TinkerBarn/U1-Argus-Remote-RFID/THIRD_PARTY_NOTICES.md

# Third-Party Notices

This repository includes ideas, implementation patterns, and in parts adapted logic from external projects.

## Included or Referenced Upstream Projects

### wasikuss / snapmaker-u1-remote-rfid-reader

- Repository: https://github.com/wasikuss/snapmaker-u1-remote-rfid-reader
- License: MIT
- Source confirmation: the repository README identifies the project as `MIT license`

Relevant note:

- MIT-licensed material remains subject to the original copyright and permission notice requirements.

### baze / snapmaker-u1-drybox-nfc-reader

- Repository: https://gitlab.com/baze/snapmaker-u1-drybox-nfc-reader
- License label shown by GitLab: Creative Commons Attribution Non Commercial 4.0 International

Relevant note:

- Because this project borrows from a source labeled `CC BY-NC 4.0`, this repository is published under a non-commercial license to stay aligned with that upstream restriction.

## Additional Acknowledgements

Special thanks and respect to:

- https://github.com/paxx12
- https://github.com/wasikuss
- https://gitlab.com/baze

## Why This Repository Uses CC BY-NC 4.0

The `wasikuss` repository is MIT, which is permissive.

The `baze` repository is labeled `Creative Commons Attribution Non Commercial 4.0 International`, which is more restrictive and prohibits commercial use.

Because material from both lines influenced this repository, the overall public repository is distributed under `CC BY-NC 4.0` so that the resulting publication does not become more permissive than the most restrictive upstream source used here.
