TinkerBarn/U1-Argus-Remote-RFID/docs/USER_GUIDE_ESP32-S3.md

# User Guide: ESP32-S3 Dual-Reader

This guide describes the ESP32-S3 N16R8 `V1.8` version of the U1 Argus Remote
RFID reader. One controller operates two PN532 readers for the left and right
spool positions and sends detected data to their assigned Snapmaker U1 Tool
Heads.

## Requirements

- ESP32-S3 N16R8 with two PN532 modules in HSU/UART mode
- Installed ESP32-S3 firmware `V1.8`
- Snapmaker U1 with Extended Firmware
- **Filament Detection** set to **External** in the printer firmware settings
- A **2.4 GHz** Wi-Fi network

The ESP32-S3 supports `802.11 b/g/n` Wi-Fi in the 2.4 GHz band. It cannot
connect to a 5 GHz-only network, even when other nearby devices preferentially
use 5 GHz.

## Printable SH02 Installation

The MakerWorld model below provides a base plate optimized for one or two
**Sovol / Comgrow SH02** filament dryers, with a front ESP32-S3 mounting
position and two matching PN532 sensor holders:

- [Dual RFID Reader for SH02 Dryer and Snapmaker U1](https://makerworld.com/en/models/2847054-dual-rfid-reader-for-sh02-dryer-and-snapmaker-u1#profileId-3175165)

The same model also provides optional ESP32-C3 holder parts and universal
ESP32-C3 holder variants for alternative installations.

## What The S3 Version Does Differently

The S3 release combines two local readers in one controller:

- **Left spool** and **Right spool** each have their own PN532 module and
  Tool Head assignment.
- A FreeRTOS task on Core 0 services the NFC readers.
- The Arduino main loop on Core 1 services the web interface, Wi-Fi, and
  printer communication.
- The validated fast PN532 HSU read path supports OpenSpool/NTAG and
  QIDI/MIFARE Classic tags.

This separation keeps blocking NFC polling away from web and network
processing. `V1.8` retains the permanent dual-slot layout for signed OTA
firmware updates, safer card identity handling, and printer self-heal behavior.
It keeps both unloaded readers on the fast polling interval after feeder
activity and sends fully read tag metadata immediately. It also provides an
optional UID-only mode for paxx12/Spoolman installations.

## First Setup

On first boot, or after stored settings have been cleared, the device opens:

- SSID: `U1-Argus-Setup-XXXX`
- Configuration page: `http://192.168.4.1`

Connect a phone or computer to the hotspot. If the captive portal does not
open automatically, open the configuration address manually.

## Setup Web Interface

| Setting | Purpose |
| --- | --- |
| Wi-Fi SSID / Password | Access to the 2.4 GHz Wi-Fi network with the Snapmaker U1 |
| Preferred BSSID 1 / 2 | Optional priority for particular 2.4 GHz access points broadcasting the same SSID |
| Hostname | Local reader name, for example `argus-dual`; accessible as `http://argus-dual.local` |
| Printer IP / Hostname | IP address or mDNS hostname of the Snapmaker U1 |
| Printer Port | API port; default is `7125` |
| Left spool Tool Head | Printer channel for the local left PN532 |
| Right spool Tool Head | Printer channel for the local right PN532 |
| Additional dual reader | Optional link to another two-spool reader with its left/right Tool Heads |
| OpenSpool UID-only Mode | Sends only the UID of every readable tag so paxx12 can resolve filament data through Spoolman; disabled by default |
| Debug serial log | Additional serial output and a live dashboard log panel; it can slow tag detection and is disabled by default |
| QIDI config upload / reset | Updates or removes custom QIDI material and manufacturer mappings |
| Signed Firmware Update | Automatically checks the published S3 update catalog and installs a selected signed OTA file with visible progress |

With debug disabled, essential serial information remains available, including
the setup hotspot, Wi-Fi status, a tag detection line, and printer transfer
status. `V1.8` also reports visible 2.4 GHz BSSIDs for the configured
SSID with their RSSI values when the list is initially scanned or changes.

When opened from the first-boot captive portal, Setup intentionally shows only
the fields required for initial Wi-Fi, reader, printer, and local tool-head
configuration. Advanced sections such as QIDI config upload, signed firmware
update, diagnostics, and additional-reader configuration are available after
the device has joined Wi-Fi and Setup is opened from the normal dashboard.

Setup provides Save-and-reboot controls at the beginning and end of the form,
plus a fixed bottom save bar. Enable **Debug serial log**, save, and allow the
reader to restart before looking for the live log on the dashboard.

## DebugSerial Live Log

When **Debug serial log** is enabled, the dashboard shows a live copy of the
firmware's serial output. The panel can be expanded, paused, cleared, kept
scrolled to the newest line, or downloaded as a text file. It uses a bounded
RAM buffer; older lines are replaced when the device buffer fills, and the
page marks that gap. Logs are not written to flash.

The `FLOW` lines distinguish the important stages of a moving-tag read:

- `UID detected` means the PN532 saw a tag, but its content may not yet be complete.
- `OpenSpool content read=OK/FAILED` reports whether the payload was read.
- `queue=accepted` and `dequeue ... wait=` show handoff to printer processing.
- `SET BLOCKED` explains that the filament sensor state prevented an update.
- `SET START` and `SET END` show the actual printer request and HTTP result.

Keep the live log disabled for normal printing because verbose serial output
can reduce RFID timing margin.

## Printer Send Compatibility

`V1.8` sends `CARD_UID` with parsed QIDI and OpenSpool tag data so newer
printer-side integrations can identify the physical card. It also sends
`CARD_TYPE` where supported:

| Tag family | `CARD_TYPE` |
| --- | --- |
| QIDI / MIFARE Classic | `M1` |
| OpenSpool / NTAG / MIFARE Ultralight | `NTAG` |

If the printer firmware rejects `CARD_TYPE`, the reader automatically retries
the same update without `CARD_TYPE` and keeps using `CARD_UID`.

After a complete tag read, V1.8 sends the full mapped metadata immediately.
It does not send UID-only data after a temporary tag read or parse failure.
This avoids clearing existing printer filament data when a tag was only
partially read while moving past the PN532.

In normal mode, a correctly read NTAG with a valid but empty NDEF record
(`Len=0`) is treated as an intentional UID-only lookup tag. A failed memory
read, missing NDEF structure, malformed record, or unsupported non-empty
content does not activate this fallback.

If the printer later reports a previously updated channel as cleared
(`NONE`, no card UID, and zero temperatures), the reader can re-send the last
successfully sent tag payload for that spool as a self-heal repair. This repair
is allowed both before and after the Tool Head filament sensor reports
`filament_detected=true`. Normal new-tag changes are still only allowed while
`filament_detected=false`.

## OpenSpool UID-only Mode

V1.8 adds **OpenSpool UID-only Mode** to Setup. It is disabled by default.
When enabled, the reader stops after detecting a tag UID and sends a standard
printer update containing the assigned channel and `CARD_UID` only. It does
not authenticate QIDI data or read NDEF/OpenSpool filament information from
the tag.

Requirements:

- Snapmaker U1 running paxx12 firmware with the Spoolman option enabled
- A reachable Spoolman server
- A filament/spool record in Spoolman whose UID exactly matches the detected tag

This mode reduces the amount of RFID reading and data transfer, uses the
filament information maintained in Spoolman, and can support otherwise unknown
tags as long as the PN532 can detect their UID. Its limitation is intentional:
without a matching Spoolman profile for that UID, no filament metadata can be
resolved. Disable the setting to restore normal QIDI/OpenSpool content reading
and the empty-NDEF NTAG fallback.

## Preferred BSSIDs

A **BSSID** is the MAC address of a specific Wi-Fi radio, for example
`AA:BB:CC:DD:EE:FF`. This is useful when several access points or mesh nodes
broadcast the same SSID and the reader should prefer a nearby or stable
2.4 GHz access point.

When BSSIDs are configured, the firmware connects in this order:

1. It scans visible networks for the configured SSID and BSSID 1.
2. If BSSID 1 is not visible, it tries BSSID 2.
3. Only when neither preferred access point is visible does it use another
   visible access point with the same SSID.

Enter only the BSSID of a **2.4 GHz** network. The ESP32-S3 cannot use the
BSSID of a 5 GHz radio.

### List Available BSSIDs On Windows

Open PowerShell or Command Prompt:

```powershell
netsh wlan show networks mode=bssid
```

For a shorter PowerShell view:

```powershell
netsh wlan show networks mode=bssid | Select-String 'SSID|BSSID|Signal|Channel'
```

Find your SSID and select the BSSID of a 2.4 GHz channel. In most regions,
2.4 GHz Wi-Fi channels are numbered from `1` through `13`.

### List Available BSSIDs On macOS

On macOS versions that still include the older `airport` system utility, run
a scan in Terminal:

```sh
/System/Library/PrivateFrameworks/Apple80211.framework/Versions/Current/Resources/airport -s
```

Apple does not include this private utility on every newer macOS version. If
the command is unavailable, open **Wireless Diagnostics** and select
**Window > Scan**, or hold `Option` while clicking the Wi-Fi icon to view the
BSSID of the currently connected access point.

## Supported Tags

- **OpenSpool / NTAG**: Reads OpenSpool NDEF content through the respective
  reader and transfers material data to its Tool Head. A valid empty NDEF
  record can be sent as a UID-only lookup.
- **QIDI / MIFARE Classic**: Authenticates and reads the QIDI data block,
  maps material, manufacturer, and color codes, and updates the relevant
  channel.
- **UID-only mode**: Uses any ISO14443A tag that the PN532 can detect and sends
  only its UID; filament data must be resolved by the printer/Spoolman setup.

## QIDI `officiall_filas_list.cfg`

The firmware includes compact default mappings for common QIDI Plus4
materials. The optional QIDI file `officiall_filas_list.cfg` can be uploaded
in Setup. The double `l` spelling is the filename expected by the firmware.

The upload persistently updates:

- material numbers and their displayed material names,
- manufacturer numbers and their displayed manufacturer names.

It does not overwrite RFID tags or install anything on the printer. Resetting
the QIDI configuration removes uploaded mappings and activates the built-in
defaults again.

## Dashboard

The S3 dashboard displays both local spool positions separately.

| Area | Information Shown |
| --- | --- |
| Status bar | Wi-Fi connection, printer reachability, and current tag status |
| Left/Right Printer Tool Head | Assigned channel and printer-confirmed manufacturer, material, color, temperature, sensor, and official data |
| Left/Right Tag Reader | Most recently read UID, tag source (`OpenSpool` or `QIDI`), manufacturer, material, color, and temperature values for each spool |
| Set result | Result of the last update to the relevant printer channel, including HTTP status |
| Network | SSID, IP address, hostname, signal strength, currently connected BSSID, firmware version, and visible 2.4 GHz BSSIDs for the configured SSID with RSSI and channel |
| Additional Reader | Quick access to an optional additional two-spool dashboard |

## Filament-Loaded Safety Lock

Starting with `V1.2`, each local reader is protected independently after
filament reaches its assigned Tool Head:

- Immediately before sending different tag data, the firmware checks the
  filament sensor for the matching Tool Head.
- A tag update is sent only when that sensor reports **No filament**.
- When a side reports **Filament detected**, RFID polling pauses for that side
  and its printer motion status is checked approximately every five seconds.
- The other spool reader remains available for a new spool and tag.
- After filament is removed, the paused side resumes normal RFID detection and
  update behavior.

This prevents an accidental or incorrect tag read from changing the material
data of filament already loaded for printing.

## Stationary Tag Throttling

Starting with `V1.3`, a spool that stops with its tag continuously in front of
a reader no longer causes continuous duplicate processing:

- The first valid tag data is handled immediately as before.
- When the same UID and decoded content remain at the same reader for
  3 seconds, that reader pauses reads for 2 seconds.
- After each pause, the tag is checked once again. If it is still unchanged,
  another 2-second pause begins.
- If the tag content changes, or a different tag is presented, the new data is
  processed immediately on the next check.

The periodic confirmation still permits the reader to correct printer data if
a previous SET request did not succeed, while preventing a parked spool from
making the dashboard slow.

## Initial Setup

1. Start the reader and connect to its `U1-Argus-Setup-XXXX` hotspot.
2. Open the captive portal, or manually open `http://192.168.4.1`.
3. Configure Wi-Fi, printer address, left/right Tool Heads, and optional
   preferred BSSIDs or additional reader dashboard.
4. Save the configuration and let the reader reboot.

## Normal Operation

1. Start the printer and the configured reader.
2. Load a filament spool with an attached OpenSpool or QIDI tag into the
   left or right dryer/reader position.
3. The reader detects the tag automatically and transfers the filament
   information to the assigned printer Tool Head when required.

Once configured, there is normally nothing else to operate: load filament and
print.

## Changing Settings Or Viewing Details

Open the configured reader URL, for example `http://argus-dual.local`, or its
displayed IP address only when you want to view dashboard details or change
setup values. Keep debug logging disabled for normal use and enable it only
temporarily for troubleshooting.

## Signed OTA Firmware Update

`V1.3` and later provide safe web-based firmware updates for the ESP32-S3:

1. Open the reader setup page through its hostname or IP address.
2. The **Signed Firmware Update** section automatically checks the published
   S3 update catalog. Select **Check for updates** to retry manually.
3. Download the offered `*.ota.signed.bin` file when a newer S3 release is
   available.
4. Select the downloaded file in the update form and confirm installation.
5. Watch the progress bar while the file is uploaded and verified.
6. After a valid update, the reader restarts; the setup page waits for the
   device to return and reloads automatically.

The reader verifies the firmware signature before activating an uploaded
image. A damaged, unsigned, or wrong image is rejected and the currently
running firmware remains available.

Important migration note: `V1.0`, `V1.1`, and `V1.2` use an older flash
layout. Install `V1.3` once through the Web Installer or USB before using OTA
updates. From `V1.3` onward, updates use the permanent dual-slot layout.

## Manual Arduino IDE Upload Settings

For the tested ESP32-S3 dual-reader board, use:

| Setting | Value |
| --- | --- |
| Board | `ESP32S3 Dev Module` |
| CPU Frequency | `240MHz (WiFi)` |
| Flash Mode | `QIO 80MHz` |
| Flash Size | `16MB (128Mb)` |
| Partition Scheme | `Custom` using the included `partitions.csv` |
| PSRAM | `OPI PSRAM` |
| Arduino Runs On / Events Run On | `Core 1` / `Core 1` |
| USB CDC On Boot | `Enabled` |
| USB Mode / Upload Mode | `Hardware CDC and JTAG` / `UART0 / Hardware CDC` |

Open the complete `source/ESP32-S3/V1.8/` sketch folder in Arduino IDE so the
included `partitions.csv`, `build_opt.h`, `ota_public_key.h`, and
`debug_log_*.h` headers are present for compilation. The permanent partition layout provides two `6.25 MiB` OTA
application slots and approximately `3.4 MiB` LittleFS capacity for future
features.

Keep `Erase All Flash Before Sketch Upload` disabled for updates if existing
settings should remain stored. Hardware testing confirmed the full `16 MB`
flash capacity on the reference N16R8 board when using the provided custom
layout. Do not replace it with the predefined
`16M Flash (3MB APP/9.9MB FATFS)` partition layout.

## Troubleshooting

For connection problems, first verify that a configured preferred BSSID
belongs to your 2.4 GHz SSID and is visible at the installation location.
Then check the printer address, port `7125`, and
**Filament Detection: External**.

## References

- [Espressif ESP32-S3 product overview](https://www.espressif.com/en/products/socs/esp32-s3/)
- [Espressif ESP32 chip comparison with Wi-Fi band and CPU information](https://docs.espressif.com/projects/esp-idf/en/v5.0.3/esp32c3/hw-reference/chip-series-comparison.html)
- [Microsoft documentation for `netsh wlan`](https://learn.microsoft.com/en-us/windows-server/administration/windows-commands/netsh-wlan)
