TinkerBarn/U1-Argus-Remote-RFID/source/ESP32-S3/V1.8/U1_Argus_Remote_RFID_ESP32-S3_N16R8_V1_8.ino

/*
  U1 Argus Remote RFID - ESP32-S3 N16R8 V1.8

  Target: ESP32-S3 N16R8 + 2x PN532 (HSU/UART)

  Required libraries:
  - Adafruit PN532
  - ArduinoJson

  Wiring for ESP32-S3 N16R8 -> PN532 in HSU/UART mode:
  - 3V3        -> both PN532 VCC
  - GND        -> both PN532 GND
  Alternative pin test:
  - GPIO11 TX  -> left PN532 pin labeled SCL
  - GPIO12 RX  -> left PN532 pin labeled SDA
  - GPIO13 TX  -> right PN532 pin labeled SCL
  - GPIO14 RX  -> right PN532 pin labeled SDA
*/

#include <WiFi.h>
#include <stdio.h>
#include <stdarg.h>
#include <string.h>
#include <DNSServer.h>
#include <WebServer.h>
#include <ESPmDNS.h>
#include <HTTPClient.h>
#include <Preferences.h>
#include <ArduinoJson.h>
#include <Adafruit_PN532.h>
#include <HWCDC.h>
#include <soc/soc_caps.h>
#include <freertos/FreeRTOS.h>
#include <freertos/task.h>
#include <freertos/queue.h>
#include <esp_ota_ops.h>
#include <Update.h>
#include "ota_public_key.h"

#ifndef ARDUINO_USB_MODE
#define ARDUINO_USB_MODE 0
#endif
#ifndef ARDUINO_USB_CDC_ON_BOOT
#define ARDUINO_USB_CDC_ON_BOOT 0
#endif

// Mirror Serial logs to the ESP32-S3 USB-Serial/JTAG port when the Arduino
// board profile maps Serial to UART0 or native USB CDC instead.
#if SOC_USB_SERIAL_JTAG_SUPPORTED && !(ARDUINO_USB_MODE && ARDUINO_USB_CDC_ON_BOOT)
static HWCDC DebugUsbJtagSerial;
#define U1A_HAS_USB_JTAG_LOG 1
#else
#define U1A_HAS_USB_JTAG_LOG 0
#endif

#include "debug_log_buffer.h"
#include "debug_log_panel.h"
static bool gDebugSerialEnabled = false;
static DebugLogBuffer<16384> webDebugLog;
static portMUX_TYPE webDebugLogMux = portMUX_INITIALIZER_UNLOCKED;
static uint32_t webDebugBootId = 0;

class SerialMirrorLogger {
static void mirrorWebDebugLog(const char* text, size_t length) {
  if (!gDebugSerialEnabled || !text || !length) return;
  // Bounded copies only; no allocation or networking while the NFC task logs.
  portENTER_CRITICAL(&webDebugLogMux);
  webDebugLog.append(text, length);
  portEXIT_CRITICAL(&webDebugLogMux);
}
public:
  void begin(unsigned long baud) {
    ::Serial.begin(baud);
#if U1A_HAS_USB_JTAG_LOG
    DebugUsbJtagSerial.begin(baud);
#endif
  }

  size_t print(const char* s) {
    mirrorWebDebugLog(s, strlen(s));
    size_t written = ::Serial.print(s);
#if U1A_HAS_USB_JTAG_LOG
    DebugUsbJtagSerial.print(s);
#endif
    return written;
  }

  size_t print(char c) {
    mirrorWebDebugLog(&c, 1);
    size_t written = ::Serial.print(c);
#if U1A_HAS_USB_JTAG_LOG
    DebugUsbJtagSerial.print(c);
#endif
    return written;
  }

  size_t print(const String& s) {
    mirrorWebDebugLog(s.c_str(), s.length());
    size_t written = ::Serial.print(s);
#if U1A_HAS_USB_JTAG_LOG
    DebugUsbJtagSerial.print(s);
#endif
    return written;
  }

  size_t println(const char* s) {
    mirrorWebDebugLog(s, strlen(s));
    mirrorWebDebugLog("\n", 1);
    size_t written = ::Serial.println(s);
#if U1A_HAS_USB_JTAG_LOG
    DebugUsbJtagSerial.println(s);
#endif
    return written;
  }

  size_t println(const String& s) {
    mirrorWebDebugLog(s.c_str(), s.length());
    mirrorWebDebugLog("\n", 1);
    size_t written = ::Serial.println(s);
#if U1A_HAS_USB_JTAG_LOG
    DebugUsbJtagSerial.println(s);
#endif
    return written;
  }

  size_t println() {
    mirrorWebDebugLog("\n", 1);
    size_t written = ::Serial.println();
#if U1A_HAS_USB_JTAG_LOG
    DebugUsbJtagSerial.println();
#endif
    return written;
  }

  int printf(const char* fmt, ...) {
    char buf[512];
    va_list args;
    va_start(args, fmt);
    int len = vsnprintf(buf, sizeof(buf), fmt, args);
    va_end(args);
    if (len < 0) return len;
    print(buf);
    return len;
  }

  void flush() {
    ::Serial.flush();
#if U1A_HAS_USB_JTAG_LOG
    DebugUsbJtagSerial.flush();
#endif
  }
};

static SerialMirrorLogger DebugSerial;
#undef Serial
#define Serial DebugSerial

// ============================== Version ==============================
static const char* FW_NAME = "U1 Argus Remote RFID";
static const char* FW_VERSION = "V1.8";
static const char* BOARD_LABEL = "ESP32-S3 N16R8";
static const char* OTA_UPDATE_CATALOG_URL = "https://tinkerbarn.github.io/U1-Argus-Remote-RFID/updates/esp32-s3.json";
static const size_t OTA_SIGNATURE_BYTES = 512;
static const size_t OTA_APP_SLOT_BYTES = 0x640000;

// ============================== Debug ==============================
static const uint32_t SERIAL_BAUD = 115200;

// This S3 board has an addressable RGB LED on GPIO48, not a simple status LED.
static const int TAG_LED_PIN = -1;
static const bool TAG_LED_ACTIVE_HIGH = true;
static const uint32_t TAG_LED_HOLD_MS = 300;
static const uint32_t TAG_ERROR_BLINK_MS = 120;
#define NFC_DIAG_SERIAL (isDebugSerialEnabled())
static const uint32_t NFC_NO_TAG_LOG_MS = 5000;

// ============================== Pins ==============================
// Wiring for ESP32-S3 N16R8 -> PN532 in HSU/UART mode:
// - 3V3        -> both PN532 VCC
// - GND        -> both PN532 GND
// Alternative pin test:
// - GPIO11 TX  -> left PN532 pin labeled SCL
// - GPIO12 RX  -> left PN532 pin labeled SDA
// - GPIO13 TX  -> right PN532 pin labeled SCL
// - GPIO14 RX  -> right PN532 pin labeled SDA
//
// IMPORTANT:
// - The PN532 board must be switched to HSU/UART mode.
// - Some PN532 boards keep the printed SCL/SDA labels even when the mode
//   switches are set to HSU/UART. We therefore follow the known-good wiring
//   from your other project exactly.
// - Reset is optional and is not wired in the initial 4-wire setup.
static const uint8_t READER_COUNT = 2;
static const char* READER_LABELS[READER_COUNT] = {"Left spool", "Right spool"};
static const int PN532_RX_PINS[READER_COUNT] = {12, 14};
static const int PN532_TX_PINS[READER_COUNT] = {11, 13};
static const int PN532_RESET_PINS[READER_COUNT] = {-1, -1};
static const uint32_t PN532_BAUD = 115200;

// ============================== Timing ==============================
static const uint32_t WIFI_CONNECT_TIMEOUT_MS = 30000;
static const uint32_t WIFI_PORTAL_FALLBACK_MS = 30000;
static const uint32_t WIFI_RECOVERY_RETRY_MS = 15000;
static const uint32_t WIFI_RECOVERY_ATTEMPT_MS = 6000;
static const uint32_t WIFI_STARTUP_STAGGER_MAX_MS = 2500;

// --- NFC polling intervals ---
// BENCH:  used at startup / when feeder has never triggered.  Both readers alternate.
// IDLE:   feeder known but currently inactive.  Both unlocked readers alternate at the startup interval.
// ACTIVE: one reader has focus-lock or feeder is pulling filament.  Single reader, fast.
static const uint32_t TAG_BENCH_POLL_MS = 30;     // V0.7: was 45 – faster dual-scan startup
static const uint32_t TAG_IDLE_POLL_MS = 30;     // keep unlocked readers fast after feeder events
static const uint32_t TAG_ACTIVE_POLL_MS = 12;
static const uint32_t TAG_ACTIVE_WINDOW_MS = 1200;

// Short focus while a detected tag is being handled. V0.18 releases this focus
// immediately after each completed read attempt so re-reading is not blocked.
static const uint32_t TAG_DETECT_FOCUS_MS = 600;

static const uint32_t TAG_SAME_UID_SKIP_MS = 0;
static const uint32_t TAG_UNCHANGED_ACTIVE_MS = 3000;
static const uint32_t TAG_UNCHANGED_PAUSE_MS = 2000;
static const uint32_t FEEDER_PRIORITY_WINDOW_MS = 4000; // release exclusive feeder focus sooner after one load
static const uint32_t PRINTER_MOTION_QUERY_MS = 600;
static const uint32_t PRINTER_LOADED_MOTION_QUERY_MS = 5000;
static const uint32_t PRINTER_INFO_SYNC_MS = 90000;
static const uint32_t PRINTER_WS_RECONNECT_MS = 5000;
static const uint32_t PRINTER_WS_STALE_MS = 20000;
static const uint32_t PRINTER_WS_PING_MS = 15000;
static const size_t PRINTER_WS_FRAME_BUFFER_BYTES = 8192;
static const uint32_t PRINTER_TAG_INFO_MAX_AGE_MS = 1000;
static const uint32_t PRINTER_QUERY_JITTER_MS = 450;
static const uint8_t PRINTER_QUERY_STAGGER_SLOTS = 4;
static const uint16_t PRINTER_QUERY_TIMEOUT_MS = 700;
static const uint32_t WEBHOOK_VERIFY_DELAY_MS = 1200;
static const uint32_t WEBHOOK_VERIFY_RETRY_MS = 1800;
static const uint8_t WEBHOOK_VERIFY_MAX_RETRIES = 0;
static const uint32_t WEBHOOK_RESEND_GRACE_MS = 6000;
static const uint32_t PRINTER_LOST_INFO_REPAIR_COOLDOWN_MS = 15000;
static const uint16_t PN532_CMD_TIMEOUT_MS = 100;
static const uint16_t PN532_ACK_TIMEOUT_MS = 10;
// Detect timeouts: how long InListPassiveTarget blocks waiting for a tag.
// SCAN  (dual-reader, no focus) – keep short so we rotate between readers quickly.
// ACTIVE (single focused reader) – can be longer; we know a tag is likely there.
static const uint16_t PN532_TAG_DETECT_TIMEOUT_BENCH_MS = 60;
static const uint16_t PN532_TAG_DETECT_TIMEOUT_IDLE_MS  = 60;
static const uint16_t PN532_TAG_DETECT_TIMEOUT_ACTIVE_MS = 60;
static const uint16_t PN532_MIFARE_TIMEOUT_MS = 80;
static const uint16_t PN532_FAST_READ_TIMEOUT_MS = 120;
static const bool PN532_USE_LIBRARY_TAG_DETECT = false;
static const bool PN532_SWITCH_RF_FIELD_BETWEEN_READERS = false;
static const uint8_t PN532_RF_SETTLE_MS = 8;
static const uint8_t PN532_POST_READ_RF_RESET_MS = 4;
static const uint8_t PN532_PASSIVE_RETRIES = 0x10;
static const uint8_t PN532_BOOT_RECOVERY_ATTEMPTS = 2;
static const uint8_t TAG_READ_SETTLE_MS = 2;
static const uint8_t NTAG_FIRST_USER_PAGE = 4;
static const uint8_t NTAG_LAST_USER_PAGE = 225;
static const size_t NTAG_USER_BYTES = (NTAG_LAST_USER_PAGE - NTAG_FIRST_USER_PAGE + 1) * 4;
static const uint8_t NTAG_CC_PAGE = 3;
static const uint8_t NTAG_INITIAL_FAST_READ_PAGES = 16;
static const uint8_t NTAG_FAST_READ_PAGES = 48;

// ============================== QIDI UID cache ==============================
// Disabled by default: reprogrammed QIDI tags can keep the same UID while material,
// vendor, and color bytes change.
static const uint8_t QIDI_UID_CACHE_SIZE = 4; // enough for 2 readers with one spare each
static const bool QIDI_UID_CACHE_ENABLED = false;
static const uint32_t QIDI_PRESENT_CACHE_MS = 1500;
static const uint32_t QIDI_AUTH_FAIL_COOLDOWN_MS = 250;
static const uint8_t QIDI_AUTH_SETTLE_MS = 0;
static const uint8_t NFC_QUEUE_DEPTH = 4;
static const size_t NFC_QUEUE_JSON_CAP = 2048;
static const uint32_t NFC_TASK_STACK_BYTES = 12288;

// ============================== Network defaults ==============================
static const char* AP_SSID_BASE = "U1-Argus-Setup";
static const char* AP_PASS = ""; // open AP as requested
static const uint16_t WEB_PORT = 80;
static const byte DNS_PORT = 53;
static const uint16_t DEFAULT_PRINTER_PORT = 7125;
static const uint8_t REMOTE_READER_COUNT = 1;
static const uint8_t WIFI_BSSID_COUNT = 2;
static const uint8_t WIFI_VISIBLE_BSSID_MAX = 32;
static const uint32_t WIFI_VISIBLE_BSSID_REFRESH_MS = 300000;
static const uint8_t PREF_CONFIG_VERSION = 2;
static const uint32_t PRINTER_MDNS_CACHE_MS = 120000;
static const uint32_t PRINTER_MDNS_RETRY_MS = 15000;
static const uint32_t PRINTER_MDNS_QUERY_TIMEOUT_MS = 800;
static const uint8_t QIDI_DATA_BLOCK = 4;
static const uint8_t QIDI_MAX_MATERIALS = 50;
static const uint8_t QIDI_MAX_VENDORS = 16;
static const size_t QIDI_CFG_UPLOAD_MAX_BYTES = 32000;

// ============================== Storage ==============================
Preferences prefs;
static const char* PREF_NS = "u1argus";
static const char* PREF_QIDI_NS = "u1qidi";

struct QidiMaterialRecord {
  uint8_t id;
  char type[18];
  uint16_t minTemp;
  uint16_t maxTemp;
} __attribute__((packed));

struct QidiVendorRecord {
  uint8_t id;
  char name[18];
} __attribute__((packed));

static const QidiMaterialRecord DEFAULT_QIDI_MATERIALS[] = {
  {1, "PLA", 190, 240},
  {2, "PLA", 190, 240},
  {3, "PLA", 190, 240},
  {4, "PLA", 190, 240},
  {5, "PLA-CF", 210, 250},
  {6, "PLA", 190, 240},
  {7, "PLA", 190, 240},
  {8, "PLA", 190, 230},
  {11, "ABS", 240, 280},
  {12, "ABS-GF", 240, 280},
  {13, "ABS", 240, 280},
  {14, "ABS", 240, 280},
  {18, "ASA", 240, 280},
  {19, "ASA-Aero", 240, 280},
  {24, "UltraPA", 260, 300},
  {25, "PA12-CF", 260, 300},
  {26, "UltraPA-CF25", 300, 320},
  {30, "PAHT-CF", 300, 320},
  {31, "PAHT-GF", 300, 320},
  {32, "PAHT-S", 260, 280},
  {33, "PA-S", 260, 280},
  {34, "PC-ABS-FR", 260, 280},
  {37, "PET-CF", 280, 320},
  {38, "PET-GF", 280, 320},
  {39, "PETG", 240, 280},
  {40, "PETG", 240, 275},
  {41, "PETG", 220, 270},
  {44, "PPS-CF", 300, 350},
  {45, "PETG", 240, 280},
  {47, "PVA", 210, 250},
  {49, "TPU-AERO", 200, 250},
  {50, "TPU", 200, 250}
};

static const QidiVendorRecord DEFAULT_QIDI_VENDORS[] = {
  {0, "Generic"},
  {1, "QIDI"}
};

static const uint32_t QIDI_COLOR_RGB[] = {
  0x000000, 0xFAFAFA, 0x060606, 0xD9E3ED, 0x5CF30F, 0x63E492,
  0x2850FF, 0xFE98FE, 0xDFD628, 0x228332, 0x99DEFF, 0x1714B0,
  0xCEC0FE, 0xCADE4B, 0x1353AB, 0x5EA9FD, 0xA878FF, 0xFE717A,
  0xFF362D, 0xE2DFCD, 0x898F9B, 0x6E3812, 0xCAC59F, 0xF28636,
  0xB87F2B
};

QidiMaterialRecord gQidiMaterials[QIDI_MAX_MATERIALS];
QidiVendorRecord gQidiVendors[QIDI_MAX_VENDORS];
uint8_t gQidiMaterialCount = 0;
uint8_t gQidiVendorCount = 0;
bool gQidiCustomConfig = false;
bool gQidiLastSaveOk = true;
uint16_t gQidiCfgBytes = 0;

struct Settings {
  char wifiSsid[33];
  char wifiPass[65];
  char wifiBssids[WIFI_BSSID_COUNT][18];
  char hostname[33];
  char printerIp[64];
  uint16_t printerPort;
  uint8_t channels[READER_COUNT];
  char remoteReaders[REMOTE_READER_COUNT][96];
  uint8_t remoteReaderTools[REMOTE_READER_COUNT][READER_COUNT];
  bool debugSerial;
  bool openSpoolUidOnly;
};

Settings gSettings = {
  "", "", {"", ""}, "u1-argus-rfid", "192.168.1.10", DEFAULT_PRINTER_PORT, {0, 1}, {""}, {{0, 0}}, false, false
};

// ============================== Web ==============================
WebServer web(WEB_PORT);
DNSServer dnsServer;
bool portalMode = false;
bool portalRoutesReady = false;
bool mdnsRunning = false;
char apSsid[32] = "";
String cachedPrinterAddress = "";
String cachedPrinterHost = "";
uint32_t cachedPrinterResolveMs = 0;
bool cachedPrinterResolveOk = false;
String qidiCfgUploadBuffer = "";
bool qidiCfgUploadTooLarge = false;
bool otaUploadActive = false;
bool otaUploadSuccessful = false;
String otaUploadStatus;
size_t otaUploadExpectedBytes = 0;
size_t otaUploadReceivedBytes = 0;

struct VisibleWifiBssidState {
  String bssid;
  int32_t rssi;
  int32_t channel;
  bool connected;
};

VisibleWifiBssidState gVisibleWifiBssids[WIFI_VISIBLE_BSSID_MAX];
uint8_t gVisibleWifiBssidCount = 0;
uint32_t lastVisibleWifiBssidScanMs = 0;
String visibleWifiBssidStateFingerprint;
bool visibleWifiScanSerialPending = false;

// ============================== PN532 ==============================
HardwareSerial PN532SerialLeft(1);
HardwareSerial PN532SerialRight(2);
HardwareSerial* PN532Serials[READER_COUNT] = {&PN532SerialLeft, &PN532SerialRight};
Adafruit_PN532 nfcLeft(PN532_RESET_PINS[0], &PN532SerialLeft);
Adafruit_PN532 nfcRight(PN532_RESET_PINS[1], &PN532SerialRight);
Adafruit_PN532* nfcs[READER_COUNT] = {&nfcLeft, &nfcRight};
bool nfcReady[READER_COUNT] = {false, false};
uint8_t activeReaderIndex = 0;
uint8_t activeNfcReaderIndex = 0;
#define PN532Serial (*PN532Serials[activeNfcReaderIndex])
#define nfc (*nfcs[activeNfcReaderIndex])

// ============================== Runtime state ==============================
struct TagState {
  bool hasData = false;
  bool active = false;
  uint32_t lastSeenMs = 0;
  String fingerprint;
  String uidHex;
  String vendor;
  String mainType;
  String subType;
  String colorHex;
  String source;
  int minTemp = -1;
  int maxTemp = -1;
  int bedTemp = -1;
  String openspoolJson;
  String mappedPayload;
};

struct OpenSpoolFields {
  String vendor;
  String mainType;
  String subType;
  String colorHex;
  int minTemp = -1;
  int maxTemp = -1;
  int bedTemp = -1;
  int alpha = -1;
  bool officialKnown = false;
  bool official = false;
};

struct PrinterChannelState {
  bool wifiConnected = false;
  bool queryOk = false;
  bool hasInfo = false;
  bool motionKnown = false;
  bool filamentDetected = false;
  bool officialKnown = false;
  bool official = false;
  int httpCode = 0;
  uint32_t lastQueryMs = 0;
  String endpoint;
  String error;
  String fingerprint;
  String vendor;
  String manufacturer;
  String mainType;
  String subType;
  String colorHex;
  String cardUidCsv;
  int minTemp = -1;
  int maxTemp = -1;
  int bedTemp = -1;
  String rawJson;
};

struct WebhookState {
  bool known = false;
  bool ok = false;
  int httpCode = 0;
  uint32_t lastSentMs = 0;
  String response;
};

struct NfcQueueItem {
  uint32_t queuedMs = 0;
  uint8_t reader = 0;
  uint8_t uid[10] = {0};
  uint8_t uidLen = 0;
  char source[20] = {0};
  char json[NFC_QUEUE_JSON_CAP] = {0};
};

struct StableTagThrottleState {
  bool valid = false;
  uint8_t uid[10] = {0};
  uint8_t uidLen = 0;
  String source;
  String content;
  uint32_t sameContentSinceMs = 0;
  uint32_t pauseUntilMs = 0;
};

QueueHandle_t nfcTagQueue = nullptr;
TaskHandle_t nfcTaskHandle = nullptr;
uint32_t lastPollMs[READER_COUNT] = {0, 0};
uint8_t lastAcceptedUid[READER_COUNT][10] = {{0}};
uint8_t lastAcceptedUidLen[READER_COUNT] = {0, 0};
uint32_t lastAcceptedUidMs[READER_COUNT] = {0, 0};
uint8_t lastQidiAuthFailUid[READER_COUNT][4] = {{0}};
bool lastQidiAuthFailKnown[READER_COUNT] = {false, false};
uint32_t lastQidiAuthFailMs[READER_COUNT] = {0, 0};
StableTagThrottleState stableTagThrottle[READER_COUNT];

// ============================== QIDI UID → JSON cache ==============================
// Kept as an optional implementation detail, but disabled for normal builds because
// rewritten QIDI cards can retain the same UID.
struct QidiUidCacheEntry {
  uint8_t  uid[4];
  bool     valid;
  char     json[256]; // max expected QIDI JSON is well under 200 chars
};
static QidiUidCacheEntry qidiUidCache[QIDI_UID_CACHE_SIZE] = {};

struct QidiPresenceCacheEntry {
  uint8_t uid[4];
  bool valid;
  uint32_t lastSeenMs;
  char json[256];
};
static QidiPresenceCacheEntry qidiPresenceCache[READER_COUNT] = {};

static bool qidiCacheLookup(const uint8_t* uid, String& outJson) {
  if (!QIDI_UID_CACHE_ENABLED) return false;
  for (uint8_t i = 0; i < QIDI_UID_CACHE_SIZE; i++) {
    if (!qidiUidCache[i].valid) continue;
    if (memcmp(qidiUidCache[i].uid, uid, 4) == 0) {
      outJson = String(qidiUidCache[i].json);
      return true;
    }
  }
  return false;
}

static void qidiCacheStore(const uint8_t* uid, const String& json) {
  if (!QIDI_UID_CACHE_ENABLED) return;
  // Find an empty slot; if none, evict the first (oldest) entry (simple FIFO).
  int8_t slot = -1;
  for (uint8_t i = 0; i < QIDI_UID_CACHE_SIZE; i++) {
    if (!qidiUidCache[i].valid) { slot = (int8_t)i; break; }
  }
  if (slot < 0) {
    // No free slot: rotate – shift entries down, free slot 0
    for (uint8_t i = 0; i < QIDI_UID_CACHE_SIZE - 1; i++) qidiUidCache[i] = qidiUidCache[i + 1];
    slot = QIDI_UID_CACHE_SIZE - 1;
    qidiUidCache[slot].valid = false;
  }
  memcpy(qidiUidCache[slot].uid, uid, 4);
  size_t n = json.length();
  if (n >= sizeof(qidiUidCache[slot].json)) n = sizeof(qidiUidCache[slot].json) - 1;
  memcpy(qidiUidCache[slot].json, json.c_str(), n);
  qidiUidCache[slot].json[n] = '\0';
  qidiUidCache[slot].valid = true;
}

static bool qidiPresenceCacheLookup(uint8_t reader, const uint8_t* uid, String& outJson) {
  if (reader >= READER_COUNT || !uid) return false;
  QidiPresenceCacheEntry& entry = qidiPresenceCache[reader];
  if (!entry.valid) return false;
  if (memcmp(entry.uid, uid, 4) != 0) return false;
  uint32_t now = millis();
  if ((now - entry.lastSeenMs) > QIDI_PRESENT_CACHE_MS) {
    entry.valid = false;
    return false;
  }
  entry.lastSeenMs = now;
  outJson = String(entry.json);
  return true;
}

static void qidiPresenceCacheStore(uint8_t reader, const uint8_t* uid, const String& json) {
  if (reader >= READER_COUNT || !uid) return;
  QidiPresenceCacheEntry& entry = qidiPresenceCache[reader];
  memcpy(entry.uid, uid, 4);
  size_t n = json.length();
  if (n >= sizeof(entry.json)) n = sizeof(entry.json) - 1;
  memcpy(entry.json, json.c_str(), n);
  entry.json[n] = '\0';
  entry.lastSeenMs = millis();
  entry.valid = true;
}

static void qidiPresenceCacheNoteNoTag(uint8_t reader) {
  if (reader >= READER_COUNT) return;
  QidiPresenceCacheEntry& entry = qidiPresenceCache[reader];
  if (!entry.valid) return;
  if ((millis() - entry.lastSeenMs) > QIDI_PRESENT_CACHE_MS) {
    entry.valid = false;
  }
}
uint32_t lastNfcProbeLogMs[READER_COUNT] = {0, 0};
uint32_t lastTagSeenMs[READER_COUNT] = {0, 0};
uint32_t tagLedUntilMs = 0;
uint32_t nextMotionQueryMs[READER_COUNT] = {0, 0};
uint32_t nextInfoSyncMs[READER_COUNT] = {0, 0};
uint32_t lastPrinterInfoQueryMs[READER_COUNT] = {0, 0};
uint32_t lastFeederMotionRiseMs[READER_COUNT] = {0, 0};
bool feederMotionBaselineKnown[READER_COUNT] = {false, false};
bool lastFeederMotionValue[READER_COUNT] = {false, false};
uint32_t nfcFocusUntilMs = 0;
int8_t nfcFocusReader = -1;
uint32_t pendingVerifyDueMs[READER_COUNT] = {0, 0};
uint32_t wifiLostSinceMs = 0;
uint32_t lastWifiReconnectMs = 0;
uint32_t lastWifiRecoveryMs = 0;
uint32_t stateRevision = 1;
WiFiClient printerWsClient;
bool printerWsConnected = false;
bool printerWsHandshakeDone = false;
bool printerWsSubscribed = false;
uint32_t printerWsLastActivityMs = 0;
uint32_t printerWsLastPingMs = 0;
uint32_t printerWsNextReconnectMs = 0;
uint32_t printerWsLastLogMs = 0;
uint32_t printerWsConnectAttempts = 0;
uint32_t printerWsConnectOk = 0;
uint32_t printerWsDisconnects = 0;
uint32_t printerWsHandshakeOk = 0;
uint32_t printerWsSubscribeSent = 0;
uint32_t printerWsLastTxBytes = 0;
uint32_t printerWsLastRxBytes = 0;
uint32_t printerWsFrameRxCount = 0;
uint32_t printerWsPingCount = 0;
uint8_t printerWsFrameBuf[PRINTER_WS_FRAME_BUFFER_BYTES];
size_t printerWsFrameLen = 0;
String printerWsHandshakeBuffer;
String printerWsLastError;
String printerWsLastStatusLine;
String printerWsLastHost;
String printerWsLastJsonKind;
String printerWsLastJsonId;
bool printerAcceptsCardType = true;
String lastSentFingerprint[READER_COUNT];
String lastObservedFingerprint[READER_COUNT];
uint32_t lastLostInfoRepairMs[READER_COUNT] = {0, 0};
String pendingVerifyPayload[READER_COUNT];
String pendingVerifyFingerprint[READER_COUNT];
String pendingVerifyExpectedWithUid[READER_COUNT];
String pendingVerifyExpectedNoUid[READER_COUNT];
uint8_t pendingVerifyRetriesLeft[READER_COUNT] = {0, 0};
TagState gTagStates[READER_COUNT];
PrinterChannelState gPrinterStates[READER_COUNT];
WebhookState gWebhookStates[READER_COUNT];
#define gTagState (gTagStates[activeReaderIndex])
#define gPrinterState (gPrinterStates[activeReaderIndex])
#define gWebhookState (gWebhookStates[activeReaderIndex])

// ------------------------------ Helpers ------------------------------
static String configPageHtml(const String& msg = "");
static String dashboardPageHtml();
static bool tryParseIntField(JsonVariantConst v, int& out);
static String normalizedReaderUrl(const char* raw);
static String configuredMdnsName();
static bool findNdefTlv(const uint8_t* buf, size_t len, size_t& ndefOffset, size_t& ndefLen);
static String currentPrinterComparableFingerprint();
static bool sendFilamentSetPayload(const String& payload, const String& fingerprint, const char* reason, bool pulseOnFail);
static void clearPendingVerification();
static void scheduleNextInfoSync(uint32_t now);
static void repairLostPrinterInfoIfNeeded(const char* reason);
static bool isUnsignedInteger(const String& value);
static void loadQidiConfig();
static bool importQidiCfgText(const String& cfgText, uint8_t& materialCount, uint8_t& vendorCount);
static void handleQidiCfgUpload();
static void handleQidiCfgUploadChunk();
static void handleQidiCfgReset();
static void handleOtaUpload();
static void handleOtaUploadChunk();
static void sendHtmlNoCache(int code, const String& body);
static void sendTextNoCache(int code, const String& body);
static void selectReader(uint8_t readerIndex);
static bool isDebugSerialEnabled();

static void selectReader(uint8_t readerIndex) {
  activeReaderIndex = readerIndex < READER_COUNT ? readerIndex : 0;
}

static void selectNfcReader(uint8_t readerIndex) {
  activeNfcReaderIndex = readerIndex < READER_COUNT ? readerIndex : 0;
}

static bool isDebugSerialEnabled() {
  return gDebugSerialEnabled;
}

static void debugPrintImpl(const String& msg) {
  Serial.println(msg);
}

static void debugPrintfImpl(const char* fmt, ...) {
  char buf[512];
  va_list args;
  va_start(args, fmt);
  vsnprintf(buf, sizeof(buf), fmt, args);
  va_end(args);
  Serial.print(buf);
}

#define debugPrint(msg) do { if (isDebugSerialEnabled()) debugPrintImpl(String(msg)); } while (0)
#define debugPrintf(...) do { if (isDebugSerialEnabled()) debugPrintfImpl(__VA_ARGS__); } while (0)

static String bytesToHexString(const uint8_t* data, uint8_t len) {
  String out;
  for (uint8_t i = 0; i < len; i++) {
    if (i) out += ' ';
    if (data[i] < 0x10) out += '0';
    out += String(data[i], HEX);
  }
  out.toUpperCase();
  return out;
}

static String uidBytesToCsv(const uint8_t* data, uint8_t len) {
  String out;
  for (uint8_t i = 0; i < len; i++) {
    if (i) out += ',';
    out += String((int)data[i]);
  }
  return out;
}

static String uidJsonArrayToCsv(JsonVariantConst v) {
  JsonArrayConst arr = v.as<JsonArrayConst>();
  if (arr.isNull()) return "";

  String out;
  bool first = true;
  for (JsonVariantConst item : arr) {
    int value = -1;
    if (item.is<int>()) value = item.as<int>();
    else if (item.is<long>()) value = (int)item.as<long>();
    else if (item.is<const char*>()) value = String(item.as<const char*>()).toInt();
    if (value < 0 || value > 255) continue;

    if (!first) out += ',';
    out += String(value);
    first = false;
  }
  return out;
}

static void setTagLed(bool on) {
  if (TAG_LED_PIN < 0) return;
  digitalWrite(TAG_LED_PIN, on == TAG_LED_ACTIVE_HIGH ? HIGH : LOW);
}

static void pulseTagLed() {
  setTagLed(true);
  tagLedUntilMs = millis() + TAG_LED_HOLD_MS;
}

static void pulseTagLedError() {
  setTagLed(true);
  tagLedUntilMs = millis() + TAG_ERROR_BLINK_MS;
}

static void bumpStateRevision() {
  stateRevision++;
  if (stateRevision == 0) stateRevision = 1;
}

static String rgbIntToHexString(int rgb) {
  if (rgb < 0 || rgb > 0xFFFFFF) return "";
  char buf[8];
  snprintf(buf, sizeof(buf), "#%02X%02X%02X", (rgb >> 16) & 0xFF, (rgb >> 8) & 0xFF, rgb & 0xFF);
  return String(buf);
}

static void flushPn532Input() {
  while (PN532Serial.available()) {
    (void)PN532Serial.read();
  }
}

static int16_t receivePn532Bytes(uint8_t* buf, size_t len, uint16_t timeoutMs) {
  size_t readBytes = 0;
  while (readBytes < len) {
    const uint32_t start = millis();
    int ret = -1;
    do {
      ret = PN532Serial.read();
      if (ret >= 0) break;
    } while ((timeoutMs == 0) || ((millis() - start) < timeoutMs));

    if (ret < 0) {
      if (readBytes > 0) return (int16_t)readBytes;
      return -2;
    }
    buf[readBytes++] = (uint8_t)ret;
  }
  return (int16_t)readBytes;
}

static bool pn532SendFrame(uint8_t command, const uint8_t* payload, size_t payloadLen) {
  if (payloadLen > 252) return false;

  const uint8_t dataLen = (uint8_t)(payloadLen + 2);
  const uint8_t lcs = (uint8_t)(~dataLen + 1);
  uint8_t dcs = (uint8_t)(0xD4 + command);
  for (size_t i = 0; i < payloadLen; ++i) {
    dcs = (uint8_t)(dcs + payload[i]);
  }
  dcs = (uint8_t)(~dcs + 1);

  PN532Serial.write((uint8_t)0x00);
  PN532Serial.write((uint8_t)0x00);
  PN532Serial.write((uint8_t)0xFF);
  PN532Serial.write(dataLen);
  PN532Serial.write(lcs);
  PN532Serial.write((uint8_t)0xD4);
  PN532Serial.write(command);
  for (size_t i = 0; i < payloadLen; ++i) {
    PN532Serial.write(payload[i]);
  }
  PN532Serial.write(dcs);
  PN532Serial.write((uint8_t)0x00);
  PN532Serial.flush();
  return true;
}

static bool pn532ReadAck(uint16_t timeoutMs) {
  uint8_t ack[6] = {0};
  static const uint8_t expected[6] = {0x00, 0x00, 0xFF, 0x00, 0xFF, 0x00};
  int16_t ackRead = receivePn532Bytes(ack, sizeof(ack), timeoutMs);
  if (ackRead <= 0) return false;
  for (size_t i = 0; i < sizeof(expected); ++i) {
    if (ack[i] != expected[i]) return false;
  }
  return true;
}

static bool pn532ReadResponseFrame(uint8_t expectedResponseCode,
                                   uint8_t* dataOut,
                                   size_t dataOutCap,
                                   size_t& dataLenOut,
                                   uint16_t timeoutMs) {
  uint8_t preamble[3] = {0};
  if (receivePn532Bytes(preamble, sizeof(preamble), timeoutMs) <= 0) return false;
  if (preamble[0] != 0x00 || preamble[1] != 0x00 || preamble[2] != 0xFF) return false;

  uint8_t length[2] = {0};
  if (receivePn532Bytes(length, sizeof(length), timeoutMs) <= 0) return false;
  uint8_t len = length[0];
  const uint8_t lcs = length[1];
  if ((uint8_t)(len + lcs) != 0x00) return false;
  if (len < 2) return false;
  len = (uint8_t)(len - 2);
  if (len > dataOutCap) return false;

  uint8_t cmd[2] = {0};
  if (receivePn532Bytes(cmd, sizeof(cmd), timeoutMs) <= 0) return false;
  if (cmd[0] != 0xD5 || cmd[1] != expectedResponseCode) return false;

  if (receivePn532Bytes(dataOut, len, timeoutMs) != (int16_t)len) return false;

  uint8_t checksum[2] = {0};
  if (receivePn532Bytes(checksum, sizeof(checksum), timeoutMs) <= 0) return false;
  uint8_t sum = (uint8_t)(0xD5 + expectedResponseCode);
  for (uint8_t i = 0; i < len; ++i) {
    sum = (uint8_t)(sum + dataOut[i]);
  }
  if ((uint8_t)(sum + checksum[0]) != 0x00 || checksum[1] != 0x00) return false;

  dataLenOut = len;
  return true;
}

static bool pn532Transact(uint8_t command,
                          const uint8_t* payload,
                          size_t payloadLen,
                          uint8_t expectedResponseCode,
                          uint8_t* respData,
                          size_t respCap,
                          size_t& respLen,
                          uint16_t timeoutMs) {
  flushPn532Input();
  if (!pn532SendFrame(command, payload, payloadLen)) return false;
  if (!pn532ReadAck(PN532_ACK_TIMEOUT_MS)) return false;
  return pn532ReadResponseFrame(expectedResponseCode, respData, respCap, respLen, timeoutMs);
}

static bool pn532SetRfField(bool enabled) {
  const uint8_t payload[] = {
    0x01, // RFConfiguration item: RF field
    (uint8_t)(enabled ? 0x01 : 0x00)
  };
  uint8_t resp[8] = {0};
  size_t respLen = 0;
  return pn532Transact(0x32, payload, sizeof(payload), 0x33, resp, sizeof(resp), respLen, PN532_CMD_TIMEOUT_MS);
}

static bool pn532ReleaseTargets() {
  const uint8_t payload[] = {0x00}; // release all targets
  uint8_t resp[8] = {0};
  size_t respLen = 0;
  return pn532Transact(0x52, payload, sizeof(payload), 0x53, resp, sizeof(resp), respLen, PN532_CMD_TIMEOUT_MS);
}

static void pn532ResetAfterTagRead(const char* reason) {
  bool releaseOk = pn532ReleaseTargets();
  if (releaseOk) return;

  bool offOk = pn532SetRfField(false);
  delay(PN532_POST_READ_RF_RESET_MS);
  bool onOk = pn532SetRfField(true);
  if (NFC_DIAG_SERIAL) {
    Serial.printf("[PN532 %s] post-read reset reason=%s release=failed rf_off=%s rf_on=%s\n",
                  READER_LABELS[activeNfcReaderIndex],
                  reason ? reason : "tag",
                  offOk ? "ok" : "failed",
                  onOk ? "ok" : "failed");
  }
}

static void prepareReaderRfField(uint8_t readerIndex) {
  if (!PN532_SWITCH_RF_FIELD_BETWEEN_READERS) return;

  static int8_t activeRfReader = -1;
  if (activeRfReader == (int8_t)readerIndex) return;

  for (uint8_t i = 0; i < READER_COUNT; i++) {
    if (i == readerIndex || !nfcReady[i]) continue;
    uint8_t previous = activeNfcReaderIndex;
    selectNfcReader(i);
    bool offOk = pn532SetRfField(false);
    if (NFC_DIAG_SERIAL && !offOk) {
      Serial.printf("[PN532 %s] RF field off failed\n", READER_LABELS[i]);
    }
    selectNfcReader(previous);
  }

  if (nfcReady[readerIndex]) {
    uint8_t previous = activeNfcReaderIndex;
    selectNfcReader(readerIndex);
    bool onOk = pn532SetRfField(true);
    if (NFC_DIAG_SERIAL && !onOk) {
      Serial.printf("[PN532 %s] RF field on failed\n", READER_LABELS[readerIndex]);
    }
    selectNfcReader(previous);
    delay(PN532_RF_SETTLE_MS);
  }

  activeRfReader = readerIndex;
}

static bool initPn532Reader(uint8_t reader) {
  if (reader >= READER_COUNT) return false;
  selectNfcReader(reader);
  nfcReady[reader] = false;

  if (isDebugSerialEnabled()) {
    Serial.printf("[PN532 %s] starting UART on RX=GPIO%d TX=GPIO%d\n",
                  READER_LABELS[reader],
                  PN532_RX_PINS[reader],
                  PN532_TX_PINS[reader]);
  }
  PN532Serial.end();
  delay(30);
  PN532Serial.begin(PN532_BAUD, SERIAL_8N1, PN532_RX_PINS[reader], PN532_TX_PINS[reader]);
  delay(60);
  flushPn532Input();

  uint32_t version = 0;
  for (uint8_t attempt = 0; attempt < PN532_BOOT_RECOVERY_ATTEMPTS && !version; attempt++) {
    if (attempt > 0) {
      // OTA restarts leave the PN532 powered. Recover by draining HSU and
      // toggling RF/session state before asking for firmware again.
      flushPn532Input();
      pn532ReleaseTargets();
      pn532SetRfField(false);
      delay(40);
      pn532SetRfField(true);
      delay(80);
      flushPn532Input();
    }

    if (!nfc.begin()) {
      debugPrint("[DEBUG] PN532 begin failed - check HSU mode, power and RX/TX wiring");
      continue;
    }
    version = nfc.getFirmwareVersion();
  }

  if (!version) {
    Serial.printf("[PN532 %s] not found\n", READER_LABELS[reader]);
    debugPrint("[DEBUG] PN532 firmware read failed");
    return false;
  }

  pn532ReleaseTargets();
  bool rfOffOk = pn532SetRfField(false);
  delay(20);
  bool rfOnOk = pn532SetRfField(true);
  delay(PN532_RF_SETTLE_MS);
  bool samOk = nfc.SAMConfig();
  bool retryOk = nfc.setPassiveActivationRetries(PN532_PASSIVE_RETRIES);
  nfcReady[reader] = true;

  if (isDebugSerialEnabled()) {
    Serial.printf("[PN532 %s] ready\n", READER_LABELS[reader]);
    Serial.printf("[PN532 %s] firmware IC=0x%02lX ver=%lu rev=%lu support=0x%02lX\n",
                  READER_LABELS[reader],
                  (version >> 24) & 0xFF,
                  (version >> 16) & 0xFF,
                  (version >> 8) & 0xFF,
                  version & 0xFF);
    Serial.printf("[PN532 %s] SAMConfig=%s passive_retries=0x%02X(%s) RF reset off=%s on=%s\n",
                  READER_LABELS[reader],
                  samOk ? "ok" : "failed",
                  PN532_PASSIVE_RETRIES,
                  retryOk ? "ok" : "failed",
                  rfOffOk ? "ok" : "failed",
                  rfOnOk ? "ok" : "failed");
  }

  if (PN532_SWITCH_RF_FIELD_BETWEEN_READERS) {
    bool initialOffOk = pn532SetRfField(false);
    if (isDebugSerialEnabled()) {
      Serial.printf("[PN532 %s] initial RF field off %s\n", READER_LABELS[reader], initialOffOk ? "ok" : "failed");
    }
  }
  return true;
}

static bool pn532InListPassiveTarget(uint8_t* uidOut, uint8_t& uidLenOut, uint16_t timeoutMs) {
  if (PN532_USE_LIBRARY_TAG_DETECT) {
    uint8_t libUidLen = 0;
    bool ok = nfc.readPassiveTargetID(PN532_MIFARE_ISO14443A, uidOut, &libUidLen, timeoutMs);
    if (!ok || libUidLen == 0 || libUidLen > 10) return false;
    uidLenOut = libUidLen;
    return true;
  }

  const uint8_t payload[] = {0x01, 0x00};
  uint8_t resp[64] = {0};
  size_t respLen = 0;
  if (!pn532Transact(0x4A, payload, sizeof(payload), 0x4B, resp, sizeof(resp), respLen, timeoutMs)) {
    return false;
  }
  if (respLen < 7 || resp[0] != 1) return false;
  const uint8_t uidLen = resp[5];
  if (uidLen == 0 || uidLen > 10 || respLen < (size_t)(6 + uidLen)) return false;
  uidLenOut = uidLen;
  for (uint8_t i = 0; i < uidLen; ++i) {
    uidOut[i] = resp[6 + i];
  }
  return true;
}

static bool pn532ReadPageWindow(uint8_t startPage, uint8_t* data16) {
  const uint8_t payload[] = {0x01, 0x30, startPage};
  uint8_t resp[32] = {0};
  size_t respLen = 0;
  if (!pn532Transact(0x40, payload, sizeof(payload), 0x41, resp, sizeof(resp), respLen, PN532_CMD_TIMEOUT_MS)) {
    return false;
  }
  if (respLen < 17 || resp[0] != 0x00) return false;
  memcpy(data16, resp + 1, 16);
  return true;
}

static bool pn532FastReadPages(uint8_t startPage,
                               uint8_t endPage,
                               uint8_t* dataOut,
                               size_t dataOutCap,
                               uint8_t& pageCountOut) {
  if (!dataOut || endPage < startPage) return false;
  uint8_t pageCount = (uint8_t)(endPage - startPage + 1);
  size_t dataLen = (size_t)pageCount * 4u;
  if (dataLen > dataOutCap) return false;

  const uint8_t payload[] = {0x01, 0x3A, startPage, endPage};
  uint8_t resp[1 + (NTAG_FAST_READ_PAGES * 4)] = {0};
  size_t respLen = 0;
  if (!pn532Transact(0x40, payload, sizeof(payload), 0x41, resp, sizeof(resp), respLen, PN532_FAST_READ_TIMEOUT_MS)) {
    return false;
  }
  if (respLen < (1 + dataLen) || resp[0] != 0x00) return false;

  memcpy(dataOut, resp + 1, dataLen);
  pageCountOut = pageCount;
  return true;
}

static bool pn532MifareClassicAuthBlock(const uint8_t* uid, uint8_t uidLen, uint8_t block) {
  if (!uid || uidLen != 4) return false;
  uint8_t payload[13] = {
    0x01, // target number
    0x60, // MIFARE auth with Key A
    block,
    0xFF, 0xFF, 0xFF, 0xFF, 0xFF, 0xFF,
    uid[0], uid[1], uid[2], uid[3]
  };
  uint8_t resp[8] = {0};
  size_t respLen = 0;
  if (!pn532Transact(0x40, payload, sizeof(payload), 0x41, resp, sizeof(resp), respLen, PN532_MIFARE_TIMEOUT_MS)) {
    return false;
  }
  return respLen >= 1 && resp[0] == 0x00;
}

static bool reselectCurrentTagUid(const uint8_t* uid, uint8_t uidLen, uint16_t timeoutMs);

static bool qidiAuthBlockOnce(const uint8_t* uid, uint8_t uidLen, uint8_t block) {
  if (QIDI_AUTH_SETTLE_MS > 0) delay(QIDI_AUTH_SETTLE_MS);
  return pn532MifareClassicAuthBlock(uid, uidLen, block);
}

static bool pn532MifareClassicReadBlock(uint8_t block, uint8_t* data16) {
  const uint8_t payload[] = {0x01, 0x30, block};
  uint8_t resp[24] = {0};
  size_t respLen = 0;
  if (!pn532Transact(0x40, payload, sizeof(payload), 0x41, resp, sizeof(resp), respLen, PN532_MIFARE_TIMEOUT_MS)) {
    return false;
  }
  if (respLen < 17 || resp[0] != 0x00) return false;
  memcpy(data16, resp + 1, 16);
  return true;
}

static bool ntagLastUserPageFromCc(const uint8_t* cc, uint16_t& lastPageOut) {
  if (cc[0] != 0xE1) {
    debugPrintf("[DEBUG] warning: unexpected CC magic 0x%02X\n", cc[0]);
  }
  const uint16_t dataBytes = (uint16_t)cc[2] * 8u;
  if (dataBytes < 4) return false;
  const uint16_t pageCount = dataBytes / 4u;
  lastPageOut = (uint16_t)(NTAG_FIRST_USER_PAGE + pageCount - 1u);
  if (lastPageOut > NTAG_LAST_USER_PAGE) lastPageOut = NTAG_LAST_USER_PAGE;
  return true;
}

static bool pn532GetLastUserPage(uint16_t& lastPageOut, uint8_t* ccWindowOut) {
  uint8_t cc[16] = {0};
  if (!pn532ReadPageWindow(NTAG_CC_PAGE, cc)) {
    debugPrint("[DEBUG] failed to read CC page via raw HSU");
    return false;
  }
  if (ccWindowOut) memcpy(ccWindowOut, cc, 16);
  return ntagLastUserPageFromCc(cc, lastPageOut);
}

static void copyNtagPagesToUserBuffer(uint16_t startPage,
                                      const uint8_t* data,
                                      uint8_t pageCount,
                                      uint16_t lastPage,
                                      uint8_t* out,
                                      size_t& actualLen) {
  for (uint8_t offset = 0; offset < pageCount; ++offset) {
    const uint16_t thisPage = (uint16_t)(startPage + offset);
    if (thisPage < NTAG_FIRST_USER_PAGE) continue;
    if (thisPage > lastPage) break;

    const size_t dst = (size_t)(thisPage - NTAG_FIRST_USER_PAGE) * 4u;
    out[dst + 0] = data[offset * 4 + 0];
    out[dst + 1] = data[offset * 4 + 1];
    out[dst + 2] = data[offset * 4 + 2];
    out[dst + 3] = data[offset * 4 + 3];
    actualLen = dst + 4;
  }
}

static bool hasCompleteNdefInBuffer(const uint8_t* buf, size_t len, uint16_t lastReadPage) {
  size_t ndefOffset = 0, ndefLen = 0;
  if (!findNdefTlv(buf, len, ndefOffset, ndefLen)) return false;

  const size_t needed = ndefOffset + ndefLen + 1;
  debugPrintf("[DEBUG] NDEF candidate found at offset=%u len=%u after page=%u\n",
              (unsigned)ndefOffset,
              (unsigned)ndefLen,
              (unsigned)lastReadPage);
  if (len < needed) return false;

  debugPrintf("[DEBUG] Completed raw HSU read at page=%u total=%u bytes\n",
              (unsigned)lastReadPage,
              (unsigned)len);
  return true;
}

static void safeCopy(char* dst, size_t dstSize, const String& src) {
  if (!dst || dstSize == 0) return;
  size_t n = src.length();
  if (n >= dstSize) n = dstSize - 1;
  memcpy(dst, src.c_str(), n);
  dst[n] = '\0';
}

static String cfgTrimmed(String s) {
  s.trim();
  if (s.startsWith("\"") && s.endsWith("\"") && s.length() >= 2) {
    s = s.substring(1, s.length() - 1);
    s.trim();
  }
  return s;
}

static int extractTrailingNumber(const String& text) {
  int start = -1;
  for (int i = 0; i < (int)text.length(); i++) {
    if (isDigit((unsigned char)text[i])) {
      if (start < 0) start = i;
    } else if (start >= 0) {
      return text.substring(start, i).toInt();
    }
  }
  if (start >= 0) return text.substring(start).toInt();
  return -1;
}

static uint16_t parseCfgU16(const String& text) {
  String s = text;
  s.trim();
  if (!s.length()) return 0;
  long value = s.toInt();
  if (value < 0) value = 0;
  if (value > 65535L) value = 65535L;
  return (uint16_t)value;
}

static void qidiUpsertMaterial(QidiMaterialRecord* records, uint8_t& count, const QidiMaterialRecord& rec) {
  if (rec.id == 0 || rec.id > QIDI_MAX_MATERIALS || rec.type[0] == '\0') return;
  for (uint8_t i = 0; i < count; i++) {
    if (records[i].id == rec.id) {
      records[i] = rec;
      return;
    }
  }
  if (count < QIDI_MAX_MATERIALS) {
    records[count++] = rec;
  }
}

static void qidiUpsertVendor(QidiVendorRecord* records, uint8_t& count, const QidiVendorRecord& rec) {
  if (rec.id >= QIDI_MAX_VENDORS || rec.name[0] == '\0') return;
  for (uint8_t i = 0; i < count; i++) {
    if (records[i].id == rec.id) {
      records[i] = rec;
      return;
    }
  }
  if (count < QIDI_MAX_VENDORS) {
    records[count++] = rec;
  }
}

static bool saveQidiConfig() {
  String blob;
  blob.reserve(1600);
  blob += "Q1\n";
  for (uint8_t i = 0; i < gQidiMaterialCount; i++) {
    String type = String(gQidiMaterials[i].type);
    type.replace("|", " ");
    type.replace("\n", " ");
    type.replace("\r", " ");
    blob += "M|";
    blob += String(gQidiMaterials[i].id);
    blob += "|";
    blob += type;
    blob += "|";
    blob += String(gQidiMaterials[i].minTemp);
    blob += "|";
    blob += String(gQidiMaterials[i].maxTemp);
    blob += "\n";
  }
  for (uint8_t i = 0; i < gQidiVendorCount; i++) {
    String name = String(gQidiVendors[i].name);
    name.replace("|", " ");
    name.replace("\n", " ");
    name.replace("\r", " ");
    blob += "V|";
    blob += String(gQidiVendors[i].id);
    blob += "|";
    blob += name;
    blob += "\n";
  }

  prefs.begin(PREF_QIDI_NS, false);
  prefs.clear();
  size_t written = prefs.putString("cfg", blob);
  prefs.end();
  bool ok = (written == blob.length() || written == blob.length() + 1);
  gQidiCustomConfig = (gQidiMaterialCount > 0 || gQidiVendorCount > 0);
  gQidiLastSaveOk = ok;
  gQidiCfgBytes = (uint16_t)blob.length();
  if (isDebugSerialEnabled() || !ok) {
    Serial.printf("[QIDI] cfg save %s: materials=%u vendors=%u bytes=%u written=%u\n",
                  ok ? "ok" : "failed",
                  (unsigned)gQidiMaterialCount,
                  (unsigned)gQidiVendorCount,
                  (unsigned)blob.length(),
                  (unsigned)written);
  }
  return ok;
}

static void loadQidiConfig() {
  memset(gQidiMaterials, 0, sizeof(gQidiMaterials));
  memset(gQidiVendors, 0, sizeof(gQidiVendors));
  gQidiMaterialCount = 0;
  gQidiVendorCount = 0;
  gQidiCfgBytes = 0;

  prefs.begin(PREF_QIDI_NS, true);
  String blob = prefs.getString("cfg", "");
  prefs.end();
  gQidiCfgBytes = (uint16_t)blob.length();

  size_t pos = 0;
  while (pos <= blob.length()) {
    size_t next = blob.indexOf('\n', pos);
    String line = (next == (size_t)-1) ? blob.substring(pos) : blob.substring(pos, next);
    pos = (next == (size_t)-1) ? blob.length() + 1 : next + 1;
    line.trim();
    if (!line.length() || line == "Q1") continue;

    int p1 = line.indexOf('|');
    int p2 = line.indexOf('|', p1 + 1);
    if (p1 <= 0 || p2 <= p1) continue;
    String kind = line.substring(0, p1);

    if (kind == "M") {
      int p3 = line.indexOf('|', p2 + 1);
      int p4 = line.indexOf('|', p3 + 1);
      if (p3 <= p2 || p4 <= p3 || gQidiMaterialCount >= QIDI_MAX_MATERIALS) continue;
      int id = line.substring(p1 + 1, p2).toInt();
      if (id <= 0 || id > QIDI_MAX_MATERIALS) continue;
      QidiMaterialRecord rec = {};
      rec.id = (uint8_t)id;
      safeCopy(rec.type, sizeof(rec.type), line.substring(p2 + 1, p3));
      rec.minTemp = parseCfgU16(line.substring(p3 + 1, p4));
      rec.maxTemp = parseCfgU16(line.substring(p4 + 1));
      qidiUpsertMaterial(gQidiMaterials, gQidiMaterialCount, rec);
    } else if (kind == "V") {
      if (gQidiVendorCount >= QIDI_MAX_VENDORS) continue;
      int id = line.substring(p1 + 1, p2).toInt();
      if (id < 0 || id >= QIDI_MAX_VENDORS) continue;
      QidiVendorRecord rec = {};
      rec.id = (uint8_t)id;
      safeCopy(rec.name, sizeof(rec.name), line.substring(p2 + 1));
      qidiUpsertVendor(gQidiVendors, gQidiVendorCount, rec);
    }
  }

  gQidiCustomConfig = (gQidiMaterialCount > 0 || gQidiVendorCount > 0);
  gQidiLastSaveOk = true;
  if (isDebugSerialEnabled()) {
    Serial.printf("[QIDI] cfg loaded: %s, materials=%u, vendors=%u, bytes=%u\n",
                  gQidiCustomConfig ? "custom" : "built-in",
                  (unsigned)gQidiMaterialCount,
                  (unsigned)gQidiVendorCount,
                  (unsigned)gQidiCfgBytes);
  }
}

static const QidiMaterialRecord* findQidiMaterial(uint8_t id) {
  for (uint8_t i = 0; i < gQidiMaterialCount; i++) {
    if (gQidiMaterials[i].id == id) return &gQidiMaterials[i];
  }
  for (uint8_t i = 0; i < (uint8_t)(sizeof(DEFAULT_QIDI_MATERIALS) / sizeof(DEFAULT_QIDI_MATERIALS[0])); i++) {
    if (DEFAULT_QIDI_MATERIALS[i].id == id) return &DEFAULT_QIDI_MATERIALS[i];
  }
  return nullptr;
}

static const char* qidiVendorName(uint8_t id) {
  for (uint8_t i = 0; i < gQidiVendorCount; i++) {
    if (gQidiVendors[i].id == id) return gQidiVendors[i].name;
  }
  for (uint8_t i = 0; i < (uint8_t)(sizeof(DEFAULT_QIDI_VENDORS) / sizeof(DEFAULT_QIDI_VENDORS[0])); i++) {
    if (DEFAULT_QIDI_VENDORS[i].id == id) return DEFAULT_QIDI_VENDORS[i].name;
  }
  return "QIDI";
}

static int qidiColorRgb(uint8_t colorId) {
  if (colorId == 0 || colorId >= (uint8_t)(sizeof(QIDI_COLOR_RGB) / sizeof(QIDI_COLOR_RGB[0]))) return -1;
  return (int)QIDI_COLOR_RGB[colorId];
}

static bool importQidiCfgText(const String& cfgText, uint8_t& materialCount, uint8_t& vendorCount) {
  QidiMaterialRecord materials[QIDI_MAX_MATERIALS] = {};
  QidiVendorRecord vendors[QIDI_MAX_VENDORS] = {};
  materialCount = 0;
  vendorCount = 0;

  String section;
  QidiMaterialRecord cur = {};
  bool inFila = false;

  auto commitFila = [&]() {
    if (!inFila || cur.id == 0) return;
    if (cur.type[0] == '\0') return;
    qidiUpsertMaterial(materials, materialCount, cur);
  };

  size_t pos = 0;
  while (pos <= cfgText.length()) {
    size_t next = cfgText.indexOf('\n', pos);
    String rawLine = (next == (size_t)-1) ? cfgText.substring(pos) : cfgText.substring(pos, next);
    pos = (next == (size_t)-1) ? cfgText.length() + 1 : next + 1;

    int semi = rawLine.indexOf(';');
    int hash = rawLine.indexOf('#');
    int comment = -1;
    if (semi >= 0 && hash >= 0) comment = min(semi, hash);
    else if (semi >= 0) comment = semi;
    else if (hash >= 0) comment = hash;
    if (comment >= 0) rawLine.remove(comment);

    String line = cfgTrimmed(rawLine);
    if (!line.length()) continue;

    if (line.startsWith("[") && line.endsWith("]")) {
      commitFila();
      section = cfgTrimmed(line.substring(1, line.length() - 1));
      section.toLowerCase();
      memset(&cur, 0, sizeof(cur));
      inFila = false;
      if (section.startsWith("fila")) {
        int id = extractTrailingNumber(section);
        if (id > 0 && id <= QIDI_MAX_MATERIALS) {
          cur.id = (uint8_t)id;
          inFila = true;
        }
      }
      continue;
    }

    int eq = line.indexOf('=');
    if (eq < 0) continue;
    String key = cfgTrimmed(line.substring(0, eq));
    String value = cfgTrimmed(line.substring(eq + 1));
    String lowerKey = key;
    lowerKey.toLowerCase();

    if (section == "vendor_list") {
      int id = isUnsignedInteger(lowerKey) ? lowerKey.toInt() : extractTrailingNumber(lowerKey);
      if (id >= 0 && id < QIDI_MAX_VENDORS && value.length()) {
        QidiVendorRecord rec = {};
        rec.id = (uint8_t)id;
        safeCopy(rec.name, sizeof(rec.name), value);
        qidiUpsertVendor(vendors, vendorCount, rec);
      }
      continue;
    }

    if (inFila) {
      if (lowerKey == "filament" && cur.type[0] == '\0') safeCopy(cur.type, sizeof(cur.type), value);
      else if (lowerKey == "type") safeCopy(cur.type, sizeof(cur.type), value);
      else if (lowerKey == "min_temp") cur.minTemp = parseCfgU16(value);
      else if (lowerKey == "max_temp") cur.maxTemp = parseCfgU16(value);
    }
  }
  commitFila();

  if (materialCount == 0 && vendorCount == 0) return false;
  memset(gQidiMaterials, 0, sizeof(gQidiMaterials));
  memset(gQidiVendors, 0, sizeof(gQidiVendors));
  memcpy(gQidiMaterials, materials, (size_t)materialCount * sizeof(QidiMaterialRecord));
  memcpy(gQidiVendors, vendors, (size_t)vendorCount * sizeof(QidiVendorRecord));
  gQidiMaterialCount = materialCount;
  gQidiVendorCount = vendorCount;
  bool saved = saveQidiConfig();
  return saved;
}

static void resetQidiConfig() {
  prefs.begin(PREF_QIDI_NS, false);
  prefs.clear();
  prefs.end();
  loadQidiConfig();
  Serial.println("[QIDI] cfg reset to built-in defaults");
}

static String htmlEscape(const String& in) {
  String out = in;
  out.replace("&", "&amp;");
  out.replace("<", "&lt;");
  out.replace(">", "&gt;");
  out.replace("\"", "&quot;");
  return out;
}

static void sendHtmlNoCache(int code, const String& body) {
  web.sendHeader("Cache-Control", "no-store, no-cache, must-revalidate, max-age=0");
  web.sendHeader("Pragma", "no-cache");
  web.sendHeader("Expires", "0");
  web.send(code, "text/html; charset=utf-8", body);
}

static void sendTextNoCache(int code, const String& body) {
  web.sendHeader("Cache-Control", "no-store, no-cache, must-revalidate, max-age=0");
  web.sendHeader("Pragma", "no-cache");
  web.sendHeader("Expires", "0");
  web.send(code, "text/plain; charset=utf-8", body);
}

static String normalizedReaderUrl(const char* raw) {
  String url = raw ? String(raw) : "";
  url.trim();
  if (!url.length()) return "";
  if (!url.startsWith("http://") && !url.startsWith("https://")) {
    url = "http://" + url;
  }
  return url;
}

static bool isDecDigit(char c) {
  return c >= '0' && c <= '9';
}

static bool isAlphaNumChar(char c) {
  return (c >= 'a' && c <= 'z') || (c >= 'A' && c <= 'Z') || isDecDigit(c);
}

static bool isUnsignedInteger(const String& value) {
  if (!value.length()) return false;
  for (uint16_t i = 0; i < value.length(); i++) {
    if (!isDecDigit(value[i])) return false;
  }
  return true;
}

static String normalizedHostAddress(const String& raw) {
  String value = raw;
  value.trim();
  String lower = value;
  lower.toLowerCase();
  if (lower.startsWith("http://")) {
    value = value.substring(7);
  } else if (lower.startsWith("https://")) {
    value = value.substring(8);
  }

  int slash = value.indexOf('/');
  if (slash >= 0) value = value.substring(0, slash);

  int colon = value.lastIndexOf(':');
  if (colon > 0) {
    String maybePort = value.substring(colon + 1);
    if (isUnsignedInteger(maybePort)) value = value.substring(0, colon);
  }

  value.trim();
  return value;
}

static bool isIpv4Address(const String& address) {
  IPAddress tmp;
  return tmp.fromString(address);
}

static bool isValidHostname(const String& host) {
  if (!host.length() || host.length() > 63) return false;
  if (host[0] == '.' || host[host.length() - 1] == '.') return false;

  bool hasNameChar = false;
  uint8_t labelLen = 0;
  char last = 0;
  for (uint16_t i = 0; i < host.length(); i++) {
    char c = host[i];
    if (c == '.') {
      if (labelLen == 0 || last == '-') return false;
      labelLen = 0;
      last = c;
      continue;
    }
    if (!isAlphaNumChar(c) && c != '-') return false;
    if (labelLen == 0 && c == '-') return false;
    if (!isDecDigit(c)) hasNameChar = true;
    labelLen++;
    if (labelLen > 63) return false;
    last = c;
  }
  if (labelLen == 0 || last == '-') return false;
  return hasNameChar;
}

static bool isMdnsName(const String& host) {
  String lower = host;
  lower.toLowerCase();
  return lower.endsWith(".local");
}

static String mdnsQueryName(const String& host) {
  String query = host;
  String lower = query;
  lower.toLowerCase();
  if (lower.endsWith(".local")) query = query.substring(0, query.length() - 6);
  return query;
}

static bool isValidPrinterAddress(const String& address) {
  if (!address.length()) return false;
  if (isIpv4Address(address)) return true;
  return isValidHostname(address);
}

static const char* printerAddressType(const String& address) {
  if (isIpv4Address(address)) return "ip";
  if (isMdnsName(address)) return "mdns";
  return "hostname";
}

static int8_t hexNibble(char c) {
  if (c >= '0' && c <= '9') return (int8_t)(c - '0');
  if (c >= 'a' && c <= 'f') return (int8_t)(10 + c - 'a');
  if (c >= 'A' && c <= 'F') return (int8_t)(10 + c - 'A');
  return -1;
}

static bool parseBssid(const char* value, uint8_t* bytesOut) {
  if (!value || strlen(value) != 17 || !bytesOut) return false;
  for (uint8_t i = 0; i < 6; i++) {
    const uint8_t offset = (uint8_t)(i * 3);
    int8_t high = hexNibble(value[offset]);
    int8_t low = hexNibble(value[offset + 1]);
    if (high < 0 || low < 0) return false;
    bytesOut[i] = (uint8_t)((high << 4) | low);
    if (i < 5 && value[offset + 2] != ':' && value[offset + 2] != '-') return false;
  }
  return true;
}

static bool normalizeBssid(const String& raw, char* valueOut, size_t valueOutSize) {
  if (!valueOut || valueOutSize < 18) return false;
  String value = raw;
  value.trim();
  if (!value.length()) {
    valueOut[0] = '\0';
    return true;
  }

  uint8_t bytes[6] = {0};
  if (!parseBssid(value.c_str(), bytes)) return false;
  snprintf(valueOut, valueOutSize, "%02X:%02X:%02X:%02X:%02X:%02X",
           bytes[0], bytes[1], bytes[2], bytes[3], bytes[4], bytes[5]);
  return true;
}

static bool parseIpPort(const char* address, uint16_t port) {
  if (port == 0) return false;
  String clean = normalizedHostAddress(address ? String(address) : "");
  return isValidPrinterAddress(clean);
}

static String resolvedPrinterHostForUrl() {
  String address = normalizedHostAddress(gSettings.printerIp);
  if (!address.length() || isIpv4Address(address) || !isMdnsName(address) || WiFi.status() != WL_CONNECTED) {
    return address;
  }

  uint32_t now = millis();
  if (cachedPrinterAddress == address) {
    uint32_t age = now - cachedPrinterResolveMs;
    if (cachedPrinterResolveOk && age < PRINTER_MDNS_CACHE_MS) return cachedPrinterHost;
    if (!cachedPrinterResolveOk && age < PRINTER_MDNS_RETRY_MS) return address;
  }

  IPAddress resolved = MDNS.queryHost(mdnsQueryName(address), PRINTER_MDNS_QUERY_TIMEOUT_MS);
  cachedPrinterAddress = address;
  cachedPrinterResolveMs = now;
  cachedPrinterResolveOk = ((uint32_t)resolved != 0);
  cachedPrinterHost = cachedPrinterResolveOk ? resolved.toString() : address;

  if (cachedPrinterResolveOk) {
    Serial.printf("[MDNS] Printer %s resolved to %s\n", address.c_str(), cachedPrinterHost.c_str());
  } else {
    debugPrintf("[DEBUG] Printer mDNS resolve failed for %s, falling back to hostname URL\n", address.c_str());
  }
  return cachedPrinterHost;
}

static String printerBaseUrl() {
  return String("http://") + resolvedPrinterHostForUrl() + ":" + String(gSettings.printerPort);
}

static String configuredMdnsName() {
  String host = String(gSettings.hostname);
  host.trim();
  if (!host.length()) host = "u1-argus-rfid";
  String lower = host;
  lower.toLowerCase();
  if (!lower.endsWith(".local")) host += ".local";
  return host;
}

static bool isCaptiveRequestHost(const String& host) {
  if (!host.length()) return false;
  IPAddress ip;
  if (ip.fromString(host)) return false;
  String lower = host;
  lower.toLowerCase();
  if (lower.endsWith(".local")) return false;
  return true;
}

static bool shouldRedirectToPortal() {
  if (!portalMode) return false;
  return isCaptiveRequestHost(web.hostHeader());
}

static void sendPortalRedirect() {
  IPAddress apIp = WiFi.softAPIP();
  String location = String("http://") + apIp.toString() + "/";
  web.sendHeader("Location", location, true);
  web.send(302, "text/plain", "");
}

static void sendPortalLanding() {
  if (shouldRedirectToPortal()) {
    sendPortalRedirect();
  } else {
    sendHtmlNoCache(200, portalMode ? configPageHtml() : dashboardPageHtml());
  }
}

// ------------------------------ Settings ------------------------------
static void loadSettings() {
  prefs.begin(PREF_NS, true);
  String ssid = prefs.getString("wifi_ssid", "");
  String pass = prefs.getString("wifi_pass", "");
  String bssids[WIFI_BSSID_COUNT] = {
    prefs.getString("wifi_bssid_1", ""),
    prefs.getString("wifi_bssid_2", "")
  };
  String host = prefs.getString("hostname", "u1-argus-rfid");
  String ip = normalizedHostAddress(prefs.getString("printer_ip", "192.168.1.10"));
  uint16_t port = prefs.getUShort("printer_port", DEFAULT_PRINTER_PORT);
  uint8_t legacyChannel = prefs.getUChar("channel", 0);
  uint8_t leftChannel = prefs.getUChar("channel_left", legacyChannel);
  uint8_t rightChannel = prefs.getUChar("channel_right", legacyChannel < 3 ? legacyChannel + 1 : 1);
  bool debugSerial = prefs.getBool("debug_serial", false);
  bool openSpoolUidOnly = prefs.getBool("openspool_uid", false);
  if (port == 0) port = DEFAULT_PRINTER_PORT;
  if (!isValidPrinterAddress(ip)) ip = "192.168.1.10";

  safeCopy(gSettings.wifiSsid, sizeof(gSettings.wifiSsid), ssid);
  safeCopy(gSettings.wifiPass, sizeof(gSettings.wifiPass), pass);
  for (uint8_t i = 0; i < WIFI_BSSID_COUNT; i++) {
    if (!normalizeBssid(bssids[i], gSettings.wifiBssids[i], sizeof(gSettings.wifiBssids[i]))) {
      gSettings.wifiBssids[i][0] = '\0';
    }
  }
  safeCopy(gSettings.hostname, sizeof(gSettings.hostname), host);
  safeCopy(gSettings.printerIp, sizeof(gSettings.printerIp), ip);
  gSettings.printerPort = port;
  gSettings.channels[0] = (leftChannel > 3) ? 0 : leftChannel;
  gSettings.channels[1] = (rightChannel > 3) ? 1 : rightChannel;
  gSettings.debugSerial = debugSerial;
  gSettings.openSpoolUidOnly = openSpoolUidOnly;
  gDebugSerialEnabled = debugSerial;
  for (uint8_t i = 0; i < REMOTE_READER_COUNT; i++) {
    String key = String("reader_") + String(i + 2);
    String val = prefs.getString(key.c_str(), "");
    safeCopy(gSettings.remoteReaders[i], sizeof(gSettings.remoteReaders[i]), val);

    String legacyToolKey = String("reader_tool_") + String(i + 2);
    uint8_t legacyTool = prefs.getUChar(legacyToolKey.c_str(), 0);
    String leftToolKey = String("rtool_") + String(i + 2) + "_l";
    String rightToolKey = String("rtool_") + String(i + 2) + "_r";
    uint8_t leftTool = prefs.getUChar(leftToolKey.c_str(), legacyTool);
    uint8_t rightTool = prefs.getUChar(rightToolKey.c_str(), 0);
    gSettings.remoteReaderTools[i][0] = (leftTool >= 1 && leftTool <= 4) ? leftTool : 0;
    gSettings.remoteReaderTools[i][1] = (rightTool >= 1 && rightTool <= 4) ? rightTool : 0;
  }
  prefs.end();
}

static void saveSettings() {
  prefs.begin(PREF_NS, false);
  prefs.putUChar("cfg_ver", PREF_CONFIG_VERSION);
  prefs.putString("wifi_ssid", gSettings.wifiSsid);
  prefs.putString("wifi_pass", gSettings.wifiPass);
  prefs.putString("wifi_bssid_1", gSettings.wifiBssids[0]);
  prefs.putString("wifi_bssid_2", gSettings.wifiBssids[1]);
  prefs.putString("hostname", gSettings.hostname);
  prefs.putString("printer_ip", gSettings.printerIp);
  prefs.putUShort("printer_port", gSettings.printerPort);
  prefs.putUChar("channel", gSettings.channels[0]); // legacy compatibility for older single-reader builds
  prefs.putUChar("channel_left", gSettings.channels[0]);
  prefs.putUChar("channel_right", gSettings.channels[1]);
  prefs.putBool("debug_serial", gSettings.debugSerial);
  prefs.putBool("openspool_uid", gSettings.openSpoolUidOnly);
  for (uint8_t i = 0; i < REMOTE_READER_COUNT; i++) {
    String key = String("reader_") + String(i + 2);
    prefs.putString(key.c_str(), gSettings.remoteReaders[i]);

    String leftToolKey = String("rtool_") + String(i + 2) + "_l";
    String rightToolKey = String("rtool_") + String(i + 2) + "_r";
    prefs.putUChar(leftToolKey.c_str(), gSettings.remoteReaderTools[i][0]);
    prefs.putUChar(rightToolKey.c_str(), gSettings.remoteReaderTools[i][1]);
  }
  prefs.end();
}

static String filamentDetectUrl() {
  return printerBaseUrl() + "/printer/filament_detect/set";
}

static uint8_t printerChannelIndex() {
  return gSettings.channels[activeReaderIndex] < 4 ? gSettings.channels[activeReaderIndex] : 0;
}

static uint32_t printerQueryPhaseOffsetMs() {
  return ((uint32_t)printerChannelIndex() * PRINTER_MOTION_QUERY_MS) / PRINTER_QUERY_STAGGER_SLOTS;
}

static uint32_t printerQueryJitterMs() {
  return PRINTER_QUERY_JITTER_MS ? (uint32_t)random(PRINTER_QUERY_JITTER_MS + 1) : 0;
}

static String printerMotionQueryUrl() {
  String url = printerBaseUrl() + "/printer/objects/query?filament_motion_sensor%20e";
  url += String(printerChannelIndex());
  url += "_filament=filament_detected";
  return url;
}

static String printerFilamentInfoQueryUrl() {
  String url = printerBaseUrl() + "/printer/objects/query?filament_detect=info";
  url += "&filament_motion_sensor%20e";
  url += String(printerChannelIndex());
  url += "_filament=filament_detected";
  return url;
}

static String printerChannelQueryUrl() {
  return printerFilamentInfoQueryUrl();
}

static void storeTagState(const OpenSpoolFields& fields,
                          const String& openspoolJson,
                          const uint8_t* uid,
                          uint8_t uidLen,
                          const String& mappedPayload,
                          const String& fingerprint,
                          const char* source) {
  TagState next;
  next.hasData = true;
  next.active = true;
  next.lastSeenMs = millis();
  next.fingerprint = fingerprint;
  next.uidHex = bytesToHexString(uid, uidLen);
  next.vendor = fields.vendor;
  next.mainType = fields.mainType;
  next.subType = fields.subType;
  next.colorHex = fields.colorHex;
  next.source = source ? source : "";
  next.minTemp = fields.minTemp;
  next.maxTemp = fields.maxTemp;
  next.bedTemp = fields.bedTemp;
  next.openspoolJson = openspoolJson;
  next.mappedPayload = mappedPayload;

  bool changed = !gTagState.hasData ||
                 !gTagState.active ||
                 gTagState.fingerprint != next.fingerprint ||
                 gTagState.source != next.source ||
                 gTagState.openspoolJson != next.openspoolJson ||
                 gTagState.mappedPayload != next.mappedPayload;

  gTagState = next;
  if (changed) bumpStateRevision();
}

static String printerStateFingerprint(const PrinterChannelState& state) {
  String fingerprint;
  fingerprint.reserve(256);
  fingerprint += state.vendor;
  fingerprint += '|';
  fingerprint += state.manufacturer;
  fingerprint += '|';
  fingerprint += state.mainType;
  fingerprint += '|';
  fingerprint += state.subType;
  fingerprint += '|';
  fingerprint += state.colorHex;
  fingerprint += '|';
  fingerprint += state.cardUidCsv;
  fingerprint += '|';
  fingerprint += String(state.minTemp);
  fingerprint += '|';
  fingerprint += String(state.maxTemp);
  fingerprint += '|';
  fingerprint += String(state.bedTemp);
  fingerprint += '|';
  fingerprint += String(state.motionKnown ? (state.filamentDetected ? 1 : 0) : -1);
  fingerprint += '|';
  fingerprint += String(state.queryOk ? 1 : 0);
  fingerprint += '|';
  fingerprint += String(state.hasInfo ? 1 : 0);
  fingerprint += '|';
  fingerprint += state.error;
  return fingerprint;
}

static void commitPrinterState(const PrinterChannelState& next) {
  bool changed = gPrinterState.fingerprint != next.fingerprint ||
                 gPrinterState.queryOk != next.queryOk ||
                 gPrinterState.httpCode != next.httpCode;
  if (next.motionKnown && (!gPrinterState.motionKnown || next.filamentDetected != gPrinterState.filamentDetected)) {
    debugPrintf("[FLOW %lu %s] sensor filament_detected=%d; new-tag reads/SET=%s\n",
                (unsigned long)millis(), READER_LABELS[activeReaderIndex],
                next.filamentDetected ? 1 : 0, next.filamentDetected ? "blocked" : "allowed");
  }
  gPrinterState = next;
  if (changed) bumpStateRevision();
}

static void setPrinterStateDisconnected(const char* reason) {
  PrinterChannelState next = gPrinterState;
  next.wifiConnected = false;
  next.queryOk = false;
  next.hasInfo = false;
  next.motionKnown = false;
  next.httpCode = 0;
  next.error = reason ? reason : "";
  next.endpoint = printerMotionQueryUrl();
  next.lastQueryMs = millis();
  next.fingerprint = printerStateFingerprint(next);
  commitPrinterState(next);
}

static bool httpGetPrinterUrl(const String& url, String& resp, int& httpCode, bool logDetails = false) {
  if (WiFi.status() != WL_CONNECTED) {
    setPrinterStateDisconnected("Wi-Fi disconnected");
    return false;
  }

  if (logDetails) {
    Serial.printf("[DEBUG] PRINTER QUERY %s\n", url.c_str());
  }

  HTTPClient http;
  http.setTimeout(PRINTER_QUERY_TIMEOUT_MS);
  if (!http.begin(url)) {
    setPrinterStateDisconnected("HTTP begin failed");
    return false;
  }

  httpCode = http.GET();
  resp = (httpCode > 0) ? http.getString() : "";
  http.end();

  if (logDetails) {
    Serial.printf("[DEBUG] PRINTER QUERY RESULT ok=%d code=%d body=%s\n",
                  httpCode > 0 ? 1 : 0,
                  httpCode,
                  resp.c_str());
  }

  return httpCode > 0;
}

static void markPrinterQueryError(const String& url, int httpCode, const char* reason, bool clearInfo) {
  PrinterChannelState next = gPrinterState;
  next.wifiConnected = true;
  next.queryOk = false;
  if (clearInfo) next.hasInfo = false;
  next.httpCode = httpCode;
  next.error = reason ? reason : "query failed";
  next.endpoint = url;
  next.lastQueryMs = millis();
  next.fingerprint = printerStateFingerprint(next);
  commitPrinterState(next);
}

static bool updatePrinterMotionStateFromJson(const String& rawResponse, int httpCode, const String& url) {
  PrinterChannelState next = gPrinterState;
  next.wifiConnected = true;
  next.httpCode = httpCode;
  next.lastQueryMs = millis();
  next.endpoint = url;

  JsonDocument doc;
  DeserializationError err = deserializeJson(doc, rawResponse);
  if (err) {
    next.queryOk = false;
    next.error = "motion JSON decode failed";
  } else {
    JsonObject status = doc["result"]["status"];
    String sensorKey = String("filament_motion_sensor e") + String(printerChannelIndex()) + "_filament";
    JsonVariant sensor = status[sensorKey];
    if (!sensor.isNull() && sensor["filament_detected"].is<bool>()) {
      next.queryOk = true;
      next.error = "";
      next.motionKnown = true;
      next.filamentDetected = sensor["filament_detected"].as<bool>();
    } else {
      next.queryOk = false;
      next.error = "motion sensor missing";
    }
  }

  next.fingerprint = printerStateFingerprint(next);
  commitPrinterState(next);
  return gPrinterState.queryOk;
}

static bool updatePrinterInfoStateFromJson(const String& rawResponse, int httpCode, const String& url) {
  PrinterChannelState next = gPrinterState;
  next.wifiConnected = true;
  next.httpCode = httpCode;
  next.lastQueryMs = millis();
  next.endpoint = url;

  JsonDocument doc;
  DeserializationError err = deserializeJson(doc, rawResponse);
  if (err) {
    next.queryOk = false;
    next.hasInfo = false;
    next.error = "filament JSON decode failed";
    next.rawJson = "";
  } else {
    JsonObject status = doc["result"]["status"];
    JsonArray infoArr = status["filament_detect"]["info"];
    if (!infoArr.isNull() && printerChannelIndex() < infoArr.size()) {
      JsonObject info = infoArr[printerChannelIndex()];
      next.queryOk = true;
      next.hasInfo = !info.isNull();
      next.error = "";
      next.vendor = info["VENDOR"].is<const char*>() ? String(info["VENDOR"].as<const char*>()) : "";
      next.manufacturer = info["MANUFACTURER"].is<const char*>() ? String(info["MANUFACTURER"].as<const char*>()) : "";
      next.mainType = info["MAIN_TYPE"].is<const char*>() ? String(info["MAIN_TYPE"].as<const char*>()) : "";
      next.subType = info["SUB_TYPE"].is<const char*>() ? String(info["SUB_TYPE"].as<const char*>()) : "";
      next.cardUidCsv = uidJsonArrayToCsv(info["CARD_UID"]);
      next.colorHex = "";
      if (info["RGB_1"].is<int>() || info["RGB_1"].is<long>()) {
        next.colorHex = rgbIntToHexString(info["RGB_1"].as<int>());
      }
      next.minTemp = -1;
      next.maxTemp = -1;
      next.bedTemp = -1;
      if (info["HOTEND_MIN_TEMP"].is<int>() || info["HOTEND_MIN_TEMP"].is<long>()) next.minTemp = info["HOTEND_MIN_TEMP"].as<int>();
      if (info["HOTEND_MAX_TEMP"].is<int>() || info["HOTEND_MAX_TEMP"].is<long>()) next.maxTemp = info["HOTEND_MAX_TEMP"].as<int>();
      if (info["BED_TEMP"].is<int>() || info["BED_TEMP"].is<long>()) next.bedTemp = info["BED_TEMP"].as<int>();
      next.officialKnown = false;
      next.official = false;
      if (info["OFFICIAL"].is<bool>()) {
        next.officialKnown = true;
        next.official = info["OFFICIAL"].as<bool>();
      }
      next.rawJson = "";
      serializeJson(info, next.rawJson);
    } else {
      next.queryOk = false;
      next.hasInfo = false;
      next.error = "filament_detect.info missing";
      next.rawJson = "";
    }

    String sensorKey = String("filament_motion_sensor e") + String(printerChannelIndex()) + "_filament";
    JsonVariant sensor = status[sensorKey];
    if (!sensor.isNull() && sensor["filament_detected"].is<bool>()) {
      next.motionKnown = true;
      next.filamentDetected = sensor["filament_detected"].as<bool>();
    }
  }

  next.fingerprint = printerStateFingerprint(next);
  commitPrinterState(next);
  if (gPrinterState.queryOk && gPrinterState.hasInfo) {
    lastPrinterInfoQueryMs[activeReaderIndex] = millis();
  }
  return gPrinterState.queryOk && gPrinterState.hasInfo;
}

static void updatePrinterStateFromStatus(JsonObject status, const String& endpoint, int httpCode) {
  if (status.isNull()) return;
  bool relevant = status["filament_detect"].is<JsonObject>() ||
                  status["filament_feed left"].is<JsonObject>() ||
                  status["filament_feed right"].is<JsonObject>();
  if (!relevant) {
    for (uint8_t channel = 0; channel < 4; channel++) {
      String sensorKey = String("filament_motion_sensor e") + String(channel) + "_filament";
      if (status[sensorKey].is<JsonObject>()) {
        relevant = true;
        break;
      }
    }
  }
  if (!relevant) return;

  JsonArray infoArr = status["filament_detect"]["info"];
  uint8_t previousReader = activeReaderIndex;
  const uint32_t now = millis();

  for (uint8_t reader = 0; reader < READER_COUNT; reader++) {
    selectReader(reader);
    PrinterChannelState next = gPrinterState;
    next.wifiConnected = true;
    next.queryOk = true;
    next.httpCode = httpCode;
    next.lastQueryMs = now;
    next.endpoint = endpoint;
    next.error = "";

    const uint8_t channel = printerChannelIndex();
    if (!infoArr.isNull() && channel < infoArr.size()) {
      JsonObject info = infoArr[channel];
      next.hasInfo = !info.isNull();
      next.vendor = info["VENDOR"].is<const char*>() ? String(info["VENDOR"].as<const char*>()) : "";
      next.manufacturer = info["MANUFACTURER"].is<const char*>() ? String(info["MANUFACTURER"].as<const char*>()) : "";
      next.mainType = info["MAIN_TYPE"].is<const char*>() ? String(info["MAIN_TYPE"].as<const char*>()) : "";
      next.subType = info["SUB_TYPE"].is<const char*>() ? String(info["SUB_TYPE"].as<const char*>()) : "";
      next.cardUidCsv = uidJsonArrayToCsv(info["CARD_UID"]);
      next.colorHex = "";
      if (info["RGB_1"].is<int>() || info["RGB_1"].is<long>()) {
        next.colorHex = rgbIntToHexString(info["RGB_1"].as<int>());
      }
      next.minTemp = -1;
      next.maxTemp = -1;
      next.bedTemp = -1;
      if (info["HOTEND_MIN_TEMP"].is<int>() || info["HOTEND_MIN_TEMP"].is<long>()) next.minTemp = info["HOTEND_MIN_TEMP"].as<int>();
      if (info["HOTEND_MAX_TEMP"].is<int>() || info["HOTEND_MAX_TEMP"].is<long>()) next.maxTemp = info["HOTEND_MAX_TEMP"].as<int>();
      if (info["BED_TEMP"].is<int>() || info["BED_TEMP"].is<long>()) next.bedTemp = info["BED_TEMP"].as<int>();
      next.officialKnown = false;
      next.official = false;
      if (info["OFFICIAL"].is<bool>()) {
        next.officialKnown = true;
        next.official = info["OFFICIAL"].as<bool>();
      }
      next.rawJson = "";
      serializeJson(info, next.rawJson);
      lastPrinterInfoQueryMs[activeReaderIndex] = now;
    }

    String sensorKey = String("filament_motion_sensor e") + String(channel) + "_filament";
    JsonVariant sensor = status[sensorKey];
    if (!sensor.isNull() && sensor["filament_detected"].is<bool>()) {
      next.motionKnown = true;
      next.filamentDetected = sensor["filament_detected"].as<bool>();
    }

    next.fingerprint = printerStateFingerprint(next);
    commitPrinterState(next);
  }
  selectReader(previousReader);
}

static bool sendPrinterWsFrame(uint8_t opcode, const uint8_t* payload, size_t len) {
  if (!printerWsClient.connected() || len > 65535) return false;

  uint8_t header[4];
  size_t headerLen = 0;
  header[headerLen++] = (uint8_t)(0x80 | (opcode & 0x0F));
  if (len < 126) {
    header[headerLen++] = (uint8_t)(0x80 | len);
  } else {
    header[headerLen++] = 0x80 | 126;
    header[headerLen++] = (uint8_t)((len >> 8) & 0xFF);
    header[headerLen++] = (uint8_t)(len & 0xFF);
  }

  uint8_t mask[4] = {
    (uint8_t)random(0, 256),
    (uint8_t)random(0, 256),
    (uint8_t)random(0, 256),
    (uint8_t)random(0, 256)
  };

  const size_t frameLen = headerLen + sizeof(mask) + len;
  uint8_t* frame = (uint8_t*)malloc(frameLen);
  if (!frame) {
    printerWsLastError = "frame alloc failed";
    return false;
  }

  memcpy(frame, header, headerLen);
  memcpy(frame + headerLen, mask, sizeof(mask));
  uint8_t* maskedPayload = frame + headerLen + sizeof(mask);
  for (size_t i = 0; i < len; i++) maskedPayload[i] = payload[i] ^ mask[i % 4];

  size_t written = printerWsClient.write(frame, frameLen);
  free(frame);
  printerWsLastTxBytes = written;
  if (written != frameLen) {
    printerWsLastError = String("frame write short ") + String(written) + "/" + String(frameLen);
    return false;
  }
  printerWsClient.flush();
  return true;
}

static bool sendPrinterWsText(const String& text) {
  return sendPrinterWsFrame(0x1, (const uint8_t*)text.c_str(), text.length());
}

static void logPrinterWebSocketThrottled(const char* message) {
  uint32_t now = millis();
  if (printerWsLastLogMs != 0 && (now - printerWsLastLogMs) < 30000) return;
  printerWsLastLogMs = now;
  Serial.printf("[WS] %s\n", message ? message : "status");
}

static void disconnectPrinterWebSocket(const char* reason) {
  bool wasReady = printerWsConnected || printerWsHandshakeDone;
  if (printerWsClient.connected()) printerWsClient.stop();
  if (printerWsConnected || printerWsHandshakeDone) printerWsDisconnects++;
  if (reason && reason[0]) printerWsLastError = reason;
  printerWsConnected = false;
  printerWsHandshakeDone = false;
  printerWsSubscribed = false;
  printerWsFrameLen = 0;
  printerWsHandshakeBuffer = "";
  printerWsLastPingMs = 0;
  printerWsNextReconnectMs = millis() + PRINTER_WS_RECONNECT_MS;
  if (reason && wasReady) {
    logPrinterWebSocketThrottled((String("disconnected: ") + reason).c_str());
  }
}

static String printerWsSubscribePayload() {
  JsonDocument doc;
  doc["jsonrpc"] = "2.0";
  doc["method"] = "printer.objects.subscribe";
  doc["id"] = 100;
  JsonObject objects = doc["params"]["objects"].to<JsonObject>();
  JsonArray info = objects["filament_detect"].to<JsonArray>();
  info.add("info");
  objects["filament_feed left"].to<JsonVariant>().set(nullptr);
  objects["filament_feed right"].to<JsonVariant>().set(nullptr);
  for (uint8_t channel = 0; channel < 4; channel++) {
    String key = String("filament_motion_sensor e") + String(channel) + "_filament";
    JsonArray fields = objects[key].to<JsonArray>();
    fields.add("filament_detected");
  }
  String out;
  serializeJson(doc, out);
  return out;
}

static void handlePrinterWsText(const String& text) {
  printerWsLastActivityMs = millis();
  JsonDocument doc;
  DeserializationError err = deserializeJson(doc, text);
  if (err) {
    printerWsLastJsonKind = "decode failed";
    printerWsLastJsonId = "";
    printerWsLastError = String("json decode failed: ") + err.c_str();
    debugPrint("[DEBUG] WS JSON decode failed");
    return;
  }

  JsonVariant id = doc["id"];
  printerWsLastJsonId = id.isNull() ? "" : id.as<String>();
  if (!doc["method"].isNull()) {
    printerWsLastJsonKind = doc["method"].as<String>();
  } else if (!doc["result"].isNull()) {
    printerWsLastJsonKind = "result";
  } else if (!doc["error"].isNull()) {
    printerWsLastJsonKind = "error";
  } else {
    printerWsLastJsonKind = "unknown";
  }

  JsonObject status = doc["result"]["status"];
  if (!status.isNull()) {
    if (!printerWsSubscribed) Serial.println("[WS] Moonraker subscribed");
    printerWsSubscribed = true;
    printerWsLastError = "";
    updatePrinterStateFromStatus(status, "ws://printer/websocket", 200);
    return;
  }

  if (!id.isNull()) {
    long numericId = id.as<long>();
    if (numericId == 100 && !doc["result"].isNull()) {
      if (!printerWsSubscribed) Serial.println("[WS] Moonraker subscribed");
      printerWsSubscribed = true;
      printerWsLastError = "";
      return;
    }
    if (numericId == 100 && !doc["error"].isNull()) {
      printerWsLastError = "subscribe rejected";
      debugPrint("[DEBUG] WS subscribe rejected");
      return;
    }
  }

  JsonArray params = doc["params"];
  if (!params.isNull() && params.size() > 0) {
    JsonObject eventStatus = params[0];
    updatePrinterStateFromStatus(eventStatus, "ws://printer/websocket", 200);
  }
}

static bool connectPrinterWebSocket() {
  if (WiFi.status() != WL_CONNECTED || portalMode) return false;
  String host = resolvedPrinterHostForUrl();
  if (!host.length()) return false;

  printerWsConnectAttempts++;
  printerWsLastHost = host + ":" + String(gSettings.printerPort);
  printerWsLastError = "tcp connecting";
  if (!printerWsClient.connect(host.c_str(), gSettings.printerPort)) {
    printerWsNextReconnectMs = millis() + PRINTER_WS_RECONNECT_MS;
    printerWsLastError = "tcp connect failed";
    logPrinterWebSocketThrottled("connect failed, retrying");
    return false;
  }

  printerWsConnectOk++;
  printerWsClient.setTimeout(2);
  printerWsHandshakeBuffer = "";
  printerWsFrameLen = 0;
  printerWsHandshakeDone = false;
  printerWsSubscribed = false;
  printerWsConnected = true;
  printerWsLastActivityMs = millis();
  printerWsLastPingMs = millis();
  printerWsLastError = "waiting for handshake";

  printerWsClient.print(String("GET /websocket HTTP/1.1\r\n") +
                        "Host: " + host + ":" + String(gSettings.printerPort) + "\r\n" +
                        "Upgrade: websocket\r\n" +
                        "Connection: Upgrade\r\n" +
                        "Sec-WebSocket-Key: dGhlIHNhbXBsZSBub25jZQ==\r\n" +
                        "Sec-WebSocket-Version: 13\r\n\r\n");
  printerWsClient.flush();
  debugPrintf("[DEBUG] WS connecting to Moonraker %s:%u\n", host.c_str(), (unsigned)gSettings.printerPort);
  return true;
}

static void processPrinterWsFrameBuffer() {
  while (printerWsFrameLen >= 2) {
    uint8_t b0 = printerWsFrameBuf[0];
    uint8_t b1 = printerWsFrameBuf[1];
    uint8_t opcode = b0 & 0x0F;
    bool masked = (b1 & 0x80) != 0;
    uint64_t payloadLen = b1 & 0x7F;
    size_t headerLen = 2;

    if (payloadLen == 126) {
      if (printerWsFrameLen < 4) return;
      payloadLen = ((uint16_t)printerWsFrameBuf[2] << 8) | printerWsFrameBuf[3];
      headerLen = 4;
    } else if (payloadLen == 127) {
      disconnectPrinterWebSocket("unsupported large frame");
      return;
    }

    uint8_t mask[4] = {0, 0, 0, 0};
    if (masked) {
      if (printerWsFrameLen < headerLen + 4) return;
      memcpy(mask, printerWsFrameBuf + headerLen, 4);
      headerLen += 4;
    }

    if (payloadLen > PRINTER_WS_FRAME_BUFFER_BYTES || printerWsFrameLen < headerLen + payloadLen) return;

    uint8_t* payload = printerWsFrameBuf + headerLen;
    if (masked) {
      for (uint64_t i = 0; i < payloadLen; i++) payload[i] ^= mask[i % 4];
    }

    printerWsLastRxBytes = (uint32_t)payloadLen;
    printerWsFrameRxCount++;

    if (opcode == 0x1) {
      String text;
      text.reserve((size_t)payloadLen);
      for (uint64_t i = 0; i < payloadLen; i++) text += (char)payload[i];
      handlePrinterWsText(text);
    } else if (opcode == 0x8) {
      disconnectPrinterWebSocket("server close");
      return;
    } else if (opcode == 0x9) {
      sendPrinterWsFrame(0xA, payload, (size_t)payloadLen);
    } else if (opcode == 0xA) {
      printerWsLastError = "";
    }

    size_t frameLen = headerLen + (size_t)payloadLen;
    memmove(printerWsFrameBuf, printerWsFrameBuf + frameLen, printerWsFrameLen - frameLen);
    printerWsFrameLen -= frameLen;
  }
}

static void maintainPrinterWebSocket() {
  if (portalMode || WiFi.status() != WL_CONNECTED || otaUploadActive) {
    if (printerWsConnected) disconnectPrinterWebSocket("inactive");
    return;
  }

  uint32_t now = millis();
  if (!printerWsConnected || !printerWsClient.connected()) {
    printerWsConnected = false;
    if ((int32_t)(now - printerWsNextReconnectMs) >= 0) {
      connectPrinterWebSocket();
    }
    return;
  }

  if (!printerWsHandshakeDone) {
    while (printerWsClient.available()) {
      char c = (char)printerWsClient.read();
      printerWsHandshakeBuffer += c;
      if (printerWsHandshakeBuffer.indexOf("\r\n\r\n") >= 0) {
        int lineEnd = printerWsHandshakeBuffer.indexOf("\r\n");
        printerWsLastStatusLine = lineEnd > 0 ? printerWsHandshakeBuffer.substring(0, lineEnd) : printerWsHandshakeBuffer;
        if (!printerWsHandshakeBuffer.startsWith("HTTP/1.1 101")) {
          printerWsLastError = "handshake failed";
          disconnectPrinterWebSocket("handshake failed");
          return;
        }
        printerWsHandshakeOk++;
        printerWsHandshakeDone = true;
        printerWsHandshakeBuffer = "";
        printerWsLastActivityMs = now;
        if (sendPrinterWsText(printerWsSubscribePayload())) {
          printerWsSubscribeSent++;
          printerWsLastError = "subscribe sent";
          debugPrint("[DEBUG] WS Moonraker subscribe sent");
        } else {
          disconnectPrinterWebSocket("subscribe send failed");
        }
        break;
      }
      if (printerWsHandshakeBuffer.length() > 1024) {
        printerWsLastError = "handshake overflow";
        disconnectPrinterWebSocket("handshake overflow");
        return;
      }
    }
    return;
  }

  while (printerWsClient.available()) {
    if (printerWsFrameLen >= PRINTER_WS_FRAME_BUFFER_BYTES) {
      disconnectPrinterWebSocket("frame overflow");
      return;
    }
    int c = printerWsClient.read();
    if (c < 0) break;
    printerWsFrameBuf[printerWsFrameLen++] = (uint8_t)c;
    processPrinterWsFrameBuffer();
    if (!printerWsConnected) return;
  }

  if (printerWsHandshakeDone && (now - printerWsLastPingMs) > PRINTER_WS_PING_MS) {
    uint8_t pingPayload[1] = {0};
    if (sendPrinterWsFrame(0x9, pingPayload, sizeof(pingPayload))) {
      printerWsPingCount++;
      printerWsLastPingMs = now;
    } else {
      disconnectPrinterWebSocket("ping send failed");
      return;
    }
  }

}

static bool printerWebSocketReady() {
  return printerWsConnected && printerWsHandshakeDone && printerWsSubscribed && printerWsClient.connected();
}

static bool fetchPrinterMotionState() {
  String url = printerMotionQueryUrl();
  String resp;
  int httpCode = 0;
  if (!httpGetPrinterUrl(url, resp, httpCode, false)) {
    markPrinterQueryError(url, httpCode, "HTTP motion GET failed", false);
    return false;
  }
  return updatePrinterMotionStateFromJson(resp, httpCode, url);
}

static bool fetchPrinterInfoState(const char* reason) {
  String url = printerFilamentInfoQueryUrl();
  const bool initialQuery = lastPrinterInfoQueryMs[activeReaderIndex] == 0;
  const bool setVerifyQuery = reason && strcmp(reason, "set verify") == 0;
  const bool logDetails = isDebugSerialEnabled() && (initialQuery || setVerifyQuery);
  if (logDetails) {
    Serial.printf("[DEBUG] FILAMENT INFO QUERY reason=%s\n", reason ? reason : "unknown");
  }
  String resp;
  int httpCode = 0;
  if (!httpGetPrinterUrl(url, resp, httpCode, logDetails)) {
    markPrinterQueryError(url, httpCode, "HTTP filament GET failed", true);
    return false;
  }
  return updatePrinterInfoStateFromJson(resp, httpCode, url);
}

static bool fetchPrinterChannelState() {
  return fetchPrinterInfoState("compat");
}

static void scheduleNextMotionQuery(uint32_t now) {
  const bool filamentLoaded = gPrinterState.motionKnown && gPrinterState.filamentDetected;
  const uint32_t intervalMs = filamentLoaded ? PRINTER_LOADED_MOTION_QUERY_MS : PRINTER_MOTION_QUERY_MS;
  nextMotionQueryMs[activeReaderIndex] = now + intervalMs + printerQueryJitterMs();
}

static void scheduleNextInfoSync(uint32_t now) {
  nextInfoSyncMs[activeReaderIndex] = now + PRINTER_INFO_SYNC_MS + printerQueryJitterMs();
}

static void scheduleInitialPrinterQueries(uint32_t now) {
  uint32_t phase = printerQueryPhaseOffsetMs();
  nextMotionQueryMs[activeReaderIndex] = now + phase + printerQueryJitterMs();
  nextInfoSyncMs[activeReaderIndex] = now + phase + 500 + printerQueryJitterMs();
}

static bool ensureFreshPrinterInfo(const char* reason, uint32_t maxAgeMs) {
  if (WiFi.status() != WL_CONNECTED || portalMode) return false;
  if (lastPrinterInfoQueryMs[activeReaderIndex] != 0 && (millis() - lastPrinterInfoQueryMs[activeReaderIndex]) <= maxAgeMs) {
    return gPrinterState.queryOk && gPrinterState.hasInfo;
  }
  bool ok = fetchPrinterInfoState(reason);
  if (ok) scheduleNextInfoSync(millis());
  return ok;
}

static bool currentPrinterMatchesExpected(const String& expectedWithUid, const String& expectedNoUid) {
  if (!gPrinterState.queryOk || !gPrinterState.hasInfo) return false;
  String current = currentPrinterComparableFingerprint();
  return current == expectedWithUid || current == expectedNoUid;
}

static bool isNoneLikeValue(const String& value) {
  if (!value.length()) return true;
  String upper = value;
  upper.trim();
  upper.toUpperCase();
  return upper == "NONE";
}

static bool printerChannelLooksCleared() {
  if (!gPrinterState.queryOk || !gPrinterState.hasInfo) return false;

  return isNoneLikeValue(gPrinterState.vendor) &&
         isNoneLikeValue(gPrinterState.manufacturer) &&
         isNoneLikeValue(gPrinterState.mainType) &&
         isNoneLikeValue(gPrinterState.subType) &&
         gPrinterState.cardUidCsv.length() == 0 &&
         (gPrinterState.minTemp <= 0) &&
         (gPrinterState.maxTemp <= 0) &&
         (gPrinterState.bedTemp <= 0);
}

static bool canRepairLostPrinterInfo() {
  if (!gTagState.hasData || !gTagState.mappedPayload.length() || !gTagState.fingerprint.length()) return false;
  if (lastSentFingerprint[activeReaderIndex] != gTagState.fingerprint) return false;
  if (!gWebhookState.known || !gWebhookState.ok) return false;
  if (gPrinterState.lastQueryMs == 0 || (millis() - gPrinterState.lastQueryMs) > PRINTER_WS_STALE_MS) return false;
  return printerChannelLooksCleared();
}

static void repairLostPrinterInfoIfNeeded(const char* reason) {
  if (portalMode || WiFi.status() != WL_CONNECTED) return;
  if (!canRepairLostPrinterInfo()) return;

  uint32_t now = millis();
  if (lastLostInfoRepairMs[activeReaderIndex] != 0 &&
      (now - lastLostInfoRepairMs[activeReaderIndex]) < PRINTER_LOST_INFO_REPAIR_COOLDOWN_MS) {
    return;
  }

  lastLostInfoRepairMs[activeReaderIndex] = now;
  Serial.printf("[API] SET repair reason=%s reader=%s filament_detected=%d\n",
                reason ? reason : "lost printer info",
                READER_LABELS[activeReaderIndex],
                (gPrinterState.motionKnown && gPrinterState.filamentDetected) ? 1 : 0);
  if (sendFilamentSetPayload(gTagState.mappedPayload, gTagState.fingerprint, "repair lost printer info", true)) {
    clearPendingVerification();
    scheduleNextInfoSync(millis());
  }
}

static void clearPendingVerification() {
  pendingVerifyPayload[activeReaderIndex] = "";
  pendingVerifyFingerprint[activeReaderIndex] = "";
  pendingVerifyExpectedWithUid[activeReaderIndex] = "";
  pendingVerifyExpectedNoUid[activeReaderIndex] = "";
  pendingVerifyDueMs[activeReaderIndex] = 0;
  pendingVerifyRetriesLeft[activeReaderIndex] = 0;
}

static bool filamentSensorLocksReader(uint8_t reader) {
  return reader < READER_COUNT &&
         gPrinterStates[reader].motionKnown &&
         gPrinterStates[reader].filamentDetected;
}

static bool allowTagSetWithFreshFilamentState() {
  bool motionOk = gPrinterState.motionKnown &&
                  gPrinterState.lastQueryMs != 0 &&
                  (millis() - gPrinterState.lastQueryMs) <= PRINTER_WS_STALE_MS;
  if (!motionOk && !printerWebSocketReady()) {
    motionOk = fetchPrinterMotionState();
    scheduleNextMotionQuery(millis());
  }
  if (!motionOk || !gPrinterState.motionKnown) {
    debugPrintf("[FLOW %lu %s] SET BLOCKED: sensor state unavailable\n", (unsigned long)millis(), READER_LABELS[activeReaderIndex]);
    return false;
  }
  if (gPrinterState.filamentDetected) {
    clearPendingVerification();
    Serial.printf("[API] SET skipped reason=filament detected reader=%s\n", READER_LABELS[activeReaderIndex]);
    debugPrintf("[FLOW %lu %s] SET BLOCKED: filament_detected=true\n", (unsigned long)millis(), READER_LABELS[activeReaderIndex]);
    return false;
  }
  return true;
}

static void handleStateApi() {
  String etag = String("\"") + String(stateRevision) + "\"";
  if (web.hasHeader("If-None-Match") && web.header("If-None-Match") == etag) {
    web.sendHeader("ETag", etag);
    web.sendHeader("Cache-Control", "no-cache");
    web.send(304, "text/plain", "");
    return;
  }

  JsonDocument doc;
  doc["revision"] = stateRevision;
  doc["mode"] = portalMode ? "portal" : "station";

  JsonObject wifi = doc["wifi"].to<JsonObject>();
  wifi["connected"] = WiFi.status() == WL_CONNECTED;
  wifi["ssid"] = gSettings.wifiSsid;
  wifi["hostname"] = gSettings.hostname;
  wifi["ip"] = (WiFi.status() == WL_CONNECTED) ? WiFi.localIP().toString() : "";
  wifi["rssi"] = (WiFi.status() == WL_CONNECTED) ? WiFi.RSSI() : 0;
  wifi["bssid"] = (WiFi.status() == WL_CONNECTED) ? WiFi.BSSIDstr() : "";
  wifi["bssid_scan_age_ms"] = lastVisibleWifiBssidScanMs ? (millis() - lastVisibleWifiBssidScanMs) : 0;
  JsonArray visibleBssids = wifi["visible_bssids"].to<JsonArray>();
  for (uint8_t i = 0; i < gVisibleWifiBssidCount; i++) {
    JsonObject accessPoint = visibleBssids.add<JsonObject>();
    accessPoint["bssid"] = gVisibleWifiBssids[i].bssid;
    accessPoint["rssi"] = gVisibleWifiBssids[i].rssi;
    accessPoint["channel"] = gVisibleWifiBssids[i].channel;
    accessPoint["connected"] = gVisibleWifiBssids[i].connected;
  }

  JsonObject ws = doc["printer_ws"].to<JsonObject>();
  ws["connected"] = printerWebSocketReady();
  ws["handshake"] = printerWsHandshakeDone;
  ws["subscribed"] = printerWsSubscribed;
  ws["age_ms"] = printerWsLastActivityMs ? (millis() - printerWsLastActivityMs) : 0;
  ws["stale"] = !printerWebSocketReady() && (printerWsLastActivityMs == 0 || (millis() - printerWsLastActivityMs) > PRINTER_WS_STALE_MS);
  ws["last_error"] = printerWsLastError;
  ws["last_status"] = printerWsLastStatusLine;
  ws["last_host"] = printerWsLastHost;
  ws["connect_attempts"] = printerWsConnectAttempts;
  ws["connect_ok"] = printerWsConnectOk;
  ws["disconnects"] = printerWsDisconnects;
  ws["handshake_ok"] = printerWsHandshakeOk;
  ws["subscribe_sent"] = printerWsSubscribeSent;
  ws["tx_bytes"] = printerWsLastTxBytes;
  ws["rx_bytes"] = printerWsLastRxBytes;
  ws["rx_frames"] = printerWsFrameRxCount;
  ws["ping_count"] = printerWsPingCount;
  ws["last_json_kind"] = printerWsLastJsonKind;
  ws["last_json_id"] = printerWsLastJsonId;

  JsonObject printer = doc["printer"].to<JsonObject>();
  printer["channel"] = gSettings.channels[activeReaderIndex];
  printer["tool_head"] = gSettings.channels[activeReaderIndex] + 1;
  printer["address"] = gSettings.printerIp;
  printer["address_type"] = printerAddressType(String(gSettings.printerIp));
  printer["port"] = gSettings.printerPort;
  printer["endpoint"] = gPrinterState.endpoint;
  printer["query_ok"] = gPrinterState.queryOk;
  printer["age_ms"] = gPrinterState.lastQueryMs ? (millis() - gPrinterState.lastQueryMs) : 0;
  printer["vendor"] = gPrinterState.vendor;
  printer["manufacturer"] = gPrinterState.manufacturer;
  printer["main_type"] = gPrinterState.mainType;
  printer["sub_type"] = gPrinterState.subType;
  printer["color_hex"] = gPrinterState.colorHex;
  printer["card_uid"] = gPrinterState.cardUidCsv;
  if (gPrinterState.minTemp >= 0) printer["min_temp"] = gPrinterState.minTemp;
  else printer["min_temp"] = nullptr;
  if (gPrinterState.maxTemp >= 0) printer["max_temp"] = gPrinterState.maxTemp;
  else printer["max_temp"] = nullptr;
  if (gPrinterState.bedTemp >= 0) printer["bed_temp"] = gPrinterState.bedTemp;
  else printer["bed_temp"] = nullptr;
  if (gPrinterState.motionKnown) printer["filament_detected"] = gPrinterState.filamentDetected;
  else printer["filament_detected"] = nullptr;
  if (gPrinterState.officialKnown) printer["official"] = gPrinterState.official;
  else printer["official"] = nullptr;
  printer["error"] = gPrinterState.error;
  printer["raw_json"] = gPrinterState.rawJson;

  JsonObject tag = doc["tag"].to<JsonObject>();
  tag["has_data"] = gTagState.hasData;
  tag["active"] = gTagState.active;
  tag["age_ms"] = gTagState.lastSeenMs ? (millis() - gTagState.lastSeenMs) : 0;
  tag["uid"] = gTagState.uidHex;
  tag["source"] = gTagState.source;
  tag["vendor"] = gTagState.vendor;
  tag["main_type"] = gTagState.mainType;
  tag["sub_type"] = gTagState.subType;
  tag["color_hex"] = gTagState.colorHex;
  if (gTagState.minTemp >= 0) tag["min_temp"] = gTagState.minTemp;
  else tag["min_temp"] = nullptr;
  if (gTagState.maxTemp >= 0) tag["max_temp"] = gTagState.maxTemp;
  else tag["max_temp"] = nullptr;
  if (gTagState.bedTemp >= 0) tag["bed_temp"] = gTagState.bedTemp;
  else tag["bed_temp"] = nullptr;
  tag["openspool_json"] = gTagState.openspoolJson;
  tag["mapped_payload"] = gTagState.mappedPayload;

  JsonObject hook = doc["webhook"].to<JsonObject>();
  hook["known"] = gWebhookState.known;
  hook["ok"] = gWebhookState.ok;
  hook["http_code"] = gWebhookState.httpCode;
  hook["age_ms"] = gWebhookState.lastSentMs ? (millis() - gWebhookState.lastSentMs) : 0;
  hook["response"] = gWebhookState.response;

  JsonArray readers = doc["readers"].to<JsonArray>();
  uint8_t previousReader = activeReaderIndex;
  for (uint8_t readerIndex = 0; readerIndex < READER_COUNT; readerIndex++) {
    selectReader(readerIndex);
    JsonObject reader = readers.add<JsonObject>();
    reader["slot"] = readerIndex;
    reader["label"] = READER_LABELS[readerIndex];
    reader["nfc_ready"] = nfcReady[readerIndex];
    reader["channel"] = gSettings.channels[activeReaderIndex];
    reader["tool_head"] = gSettings.channels[activeReaderIndex] + 1;
    JsonObject localPrinter = reader["printer"].to<JsonObject>();
    localPrinter["endpoint"] = gPrinterState.endpoint;
    localPrinter["query_ok"] = gPrinterState.queryOk;
    localPrinter["age_ms"] = gPrinterState.lastQueryMs ? (millis() - gPrinterState.lastQueryMs) : 0;
    localPrinter["vendor"] = gPrinterState.vendor;
    localPrinter["manufacturer"] = gPrinterState.manufacturer;
    localPrinter["main_type"] = gPrinterState.mainType;
    localPrinter["sub_type"] = gPrinterState.subType;
    localPrinter["color_hex"] = gPrinterState.colorHex;
    localPrinter["card_uid"] = gPrinterState.cardUidCsv;
    if (gPrinterState.minTemp >= 0) localPrinter["min_temp"] = gPrinterState.minTemp;
    else localPrinter["min_temp"] = nullptr;
    if (gPrinterState.maxTemp >= 0) localPrinter["max_temp"] = gPrinterState.maxTemp;
    else localPrinter["max_temp"] = nullptr;
    if (gPrinterState.bedTemp >= 0) localPrinter["bed_temp"] = gPrinterState.bedTemp;
    else localPrinter["bed_temp"] = nullptr;
    if (gPrinterState.motionKnown) localPrinter["filament_detected"] = gPrinterState.filamentDetected;
    else localPrinter["filament_detected"] = nullptr;
    if (gPrinterState.officialKnown) localPrinter["official"] = gPrinterState.official;
    else localPrinter["official"] = nullptr;
    localPrinter["error"] = gPrinterState.error;
    localPrinter["raw_json"] = gPrinterState.rawJson;
    JsonObject localTag = reader["tag"].to<JsonObject>();
    localTag["has_data"] = gTagState.hasData;
    localTag["active"] = gTagState.active;
    localTag["age_ms"] = gTagState.lastSeenMs ? (millis() - gTagState.lastSeenMs) : 0;
    localTag["uid"] = gTagState.uidHex;
    localTag["source"] = gTagState.source;
    localTag["vendor"] = gTagState.vendor;
    localTag["main_type"] = gTagState.mainType;
    localTag["sub_type"] = gTagState.subType;
    localTag["color_hex"] = gTagState.colorHex;
    if (gTagState.minTemp >= 0) localTag["min_temp"] = gTagState.minTemp;
    else localTag["min_temp"] = nullptr;
    if (gTagState.maxTemp >= 0) localTag["max_temp"] = gTagState.maxTemp;
    else localTag["max_temp"] = nullptr;
    if (gTagState.bedTemp >= 0) localTag["bed_temp"] = gTagState.bedTemp;
    else localTag["bed_temp"] = nullptr;
    localTag["openspool_json"] = gTagState.openspoolJson;
    localTag["mapped_payload"] = gTagState.mappedPayload;
    JsonObject localHook = reader["webhook"].to<JsonObject>();
    localHook["known"] = gWebhookState.known;
    localHook["ok"] = gWebhookState.ok;
    localHook["http_code"] = gWebhookState.httpCode;
    localHook["age_ms"] = gWebhookState.lastSentMs ? (millis() - gWebhookState.lastSentMs) : 0;
    localHook["response"] = gWebhookState.response;
  }
  selectReader(previousReader);

  String payload;
  serializeJson(doc, payload);
  web.sendHeader("ETag", etag);
  web.sendHeader("Cache-Control", "no-cache");
  web.send(200, "application/json; charset=utf-8", payload);
}
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
void loop() {
  uint32_t now = millis();

  if (tagLedUntilMs != 0 && (int32_t)(now - tagLedUntilMs) >= 0) {
    setTagLed(false);
    tagLedUntilMs = 0;
  }

  if (portalMode) {
    dnsServer.processNextRequest();
  }
  web.handleClient();
  maintainWifiConnection();
  maintainPrinterWebSocket();
  processQueuedNfcTags();
  maintainVisibleWifiBssidScan();
  now = millis();

  for (uint8_t reader = 0; reader < READER_COUNT; reader++) {
    selectReader(reader);
    if (gTagState.active && gTagState.lastSeenMs != 0 && (now - gTagState.lastSeenMs) > TAG_ACTIVE_WINDOW_MS) {
      gTagState.active = false;
      bumpStateRevision();
    }
    processPendingSetVerification();
    processPrinterPolling();
    repairLostPrinterInfoIfNeeded("printer state");
  }
  selectReader(0);
}
