TinkerBarn/U1-Argus-Remote-RFID/(commit log)

2026-04-23 Release V1.0: add Arduino IDE setup requirements to README
2026-04-23 Docs: clarify that the reader only needs USB power after flashing and communicates with the U1 over Wi-Fi
2026-04-24 Remove screenshots and update .gitignore
    Delete obsolete screenshot assets and add the screenshots/ directory to .gitignore. This removes multiple binary image files (Captive.jpg, Dashboard01.png, Dashboard02.png, Logo01.png, Logo02.png, Schematic.png, Setup.png) from the repo and prevents them from being re-added, reducing repository bloat.
2026-05-01 Revert public release to V1.0
    [U1_Argus_Remote_RFID_V1.1.ino]
2026-05-01 Revert repository to V1_0 release
    [U1_Argus_Remote_RFID_V1_0.ino]
2026-05-03 Release U1 Argus Remote RFID V1.2
    Prepare the V1.2 public release.
    - Add V1.2 release source and firmware binary
    - Update ESP Web Tools installer to flash V1.2
    - Add V1.2 installer manifest
    - Update README with V1.2 setup, source, firmware, and release highlights
    - Add V1.2 changelog entry
    - Document Wi-Fi/hotspot recovery, reduced printer polling, and SET verification improvements
2026-05-04 Release V1.3
    - Add V1.3 release source and firmware binary
    - Update web installer to V1.3 manifest and firmware path
    - Document V1.3 printer IP/mDNS support and reader prefill helper
    - Add clean install vs update flash erase guidance
    - Update README and changelog for the current public release
2026-05-04 Split V1.3 web installer into update and clean install
    - Add V1.3 update manifest using the app image at offset 0x10000
    - Add V1.3 clean install manifest using the merged image at offset 0
    - Update web installer UI with separate Update Install and Clean Install buttons
    - Add V1.3 app binary for settings-preserving updates
    - Document NVS-preserving update behavior in README and changelog
2026-05-04 Add Arduino bootloader/partitions and docs
2026-05-06 - Fix QIDI printer update payload by omitting read-only OFFICIAL field
    [U1_Argus_Remote_RFID_V2.0.ino]
2026-05-14 Add macOS Arduino helper scripts and docs
2026-05-24 Release ESP32-S3 V1.0 and split maintenance line
2026-05-24 Document S3 screw-terminal expansion board setup
2026-05-24 Add ESP32-S3 dual-reader wiring schematic
2026-05-25 Release ESP32-C3 V2.1 with preferred BSSID support
2026-05-25 Release ESP32-S3 V1.1 with BSSID diagnostics
2026-05-25 Add MakerWorld enclosure links to documentation
2026-05-26 Release filament-loaded safety lock for C3 and S3
2026-05-26 Release ESP32-S3 V1.3 with signed OTA updates
    [partitions.csv]
2026-05-28 Release ESP32-S3 V1.4
    [partitions.csv]
2026-06-04 Release ESP32-S3 V1.5
    [partitions.csv]
2026-06-07 Release ESP32-S3 V1.6
    [partitions.csv]
2026-07-01 Clarify ESP32-S3 flash requirement
2026-11-05 Release ESP32-S3 V1.7
2026-11-06 Release ESP32-S3 V1.8
